dnekoz/WaterPressureSensor/hardware/visualization/assembly-top.png

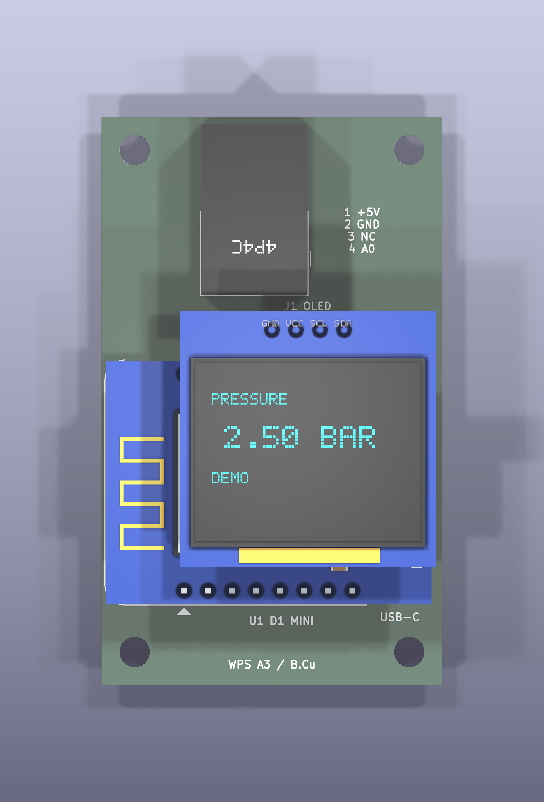
hardware/visualization/assembly-top.png
