dnekoz/WaterPressureSensor/hardware/review/carrier-bare-isometric.png

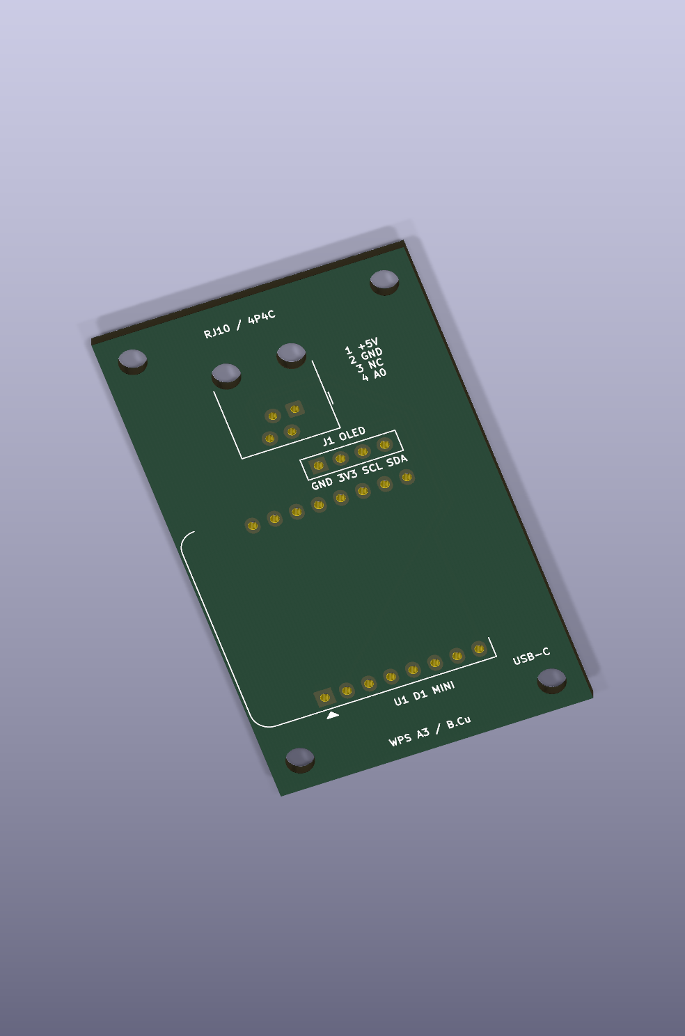
hardware/review/carrier-bare-isometric.png
