dnekoz/WaterPressureSensor/hardware/README.md

# WaterPressureSensor — аппаратная часть

Состояние: **A3, плата разведена и проверена в KiCad; выпуск для изготовления
ожидает сверки механики с реальными модулями**.

Для варианта изготовления на ЧПУ 3018 пользователь 18.10.2026 уточнил материал:
**текстолит 2 мм, медь 70 мкм**. Этот вариант, фотошаблоны, черновые УП и проверки
описаны в [cnc/README.md](cnc/README.md); старые допущения о толщине ниже к нему
не применять. Основная геометрия PCB сохранена; CAM-копия находится в `cnc/inputs/`.

Плата **36 × 60 мм**, исходная CAD-толщина 1,6 мм, одна физическая сторона меди **B.Cu**.
Все шесть цепей разведены дорожками 0,4 мм, зазор 0,25 мм; переходных отверстий
и проволочных перемычек нет. Предварительно принята медь 35 мкм.

## Зафиксированные требования

- KiCad 10.0.6; плата-носитель готовых модулей WeMos D1 Mini **USB Type-C** и SSD1306.
- Питание только через USB-разъём WeMos. Отдельный вход питания отсутствует.
- Датчик подключается через **RJ-10, 4P4C, гнездо для монтажа на плату**.
  Кабель датчика уже собран; пользователь задал контакты 1, 2 и 4.
- Сигнал датчика подключается непосредственно к A0. Внешнего делителя,
  фильтра и иных элементов согласования в этой версии нет.
- Одна сторона меди: B.Cu. Компоненты и разъёмы — с верхней стороны.
- OLED находится **вторым ярусом поверх WeMos**, подключается к высокому
  разъёму 1×4 «мама», установленному рядом с WeMos. Это последнее явное
  уточнение пользователя; вариант с двумя модулями рядом отменён.
- Нужно сохранить доступ к USB и кнопке Reset, проверить зазор по высоте,
  область антенны и возможность разборки.

## Соединения, подтверждённые прошивкой

| Сеть | Вывод WeMos | GPIO | Номер в символе U1 | Назначение |
|---|---|---|---|---|
| SENSOR_SIG | A0 | ADC | 2 | Сигнал датчика, без внешнего согласования |
| I2C_SDA | D2 | 4 | 13 | OLED SDA |
| I2C_SCL | D1 | 5 | 14 | OLED SCL |
| +3V3 | 3V3 | — | 8 | Выход встроенного стабилизатора |
| +5V_USB | 5V | — | 9 | Питание от USB WeMos |
| GND | GND | — | 10 | Общая земля |

Источники: `src/Config.h`, `src/Display.cpp`, файл варианта `d1_mini/pins_arduino.h`
из установленного ESP8266 Arduino Core 3.1.2. Назначения совпадают с README
прошивки. OLED RESET не подключается; `OLED_RESET = -1`.

Номера контактов U1 относятся к локальной копии стандартного символа
KiCad `RF_Module:WEMOS_D1_mini`. Это не нумерация GPIO.

## Распиновка датчика RJ-10, заданная пользователем

| Контакт J2 | Сеть | Соединение |
|---|---|---|
| 1 | +5V_USB | Вывод 5V WeMos, питание от его USB |
| 2 | GND | Общая земля |
| 3 | Резерв | Не подключается на плате-носителе, отмечен NC |
| 4 | SENSOR_SIG | Непосредственно A0 WeMos |

Эти соединения внесены в редактируемую схему и проверяются по экспортированному
netlist. При назначении посадочного места нумерацию его выводов необходимо
сверить с чертежом конкретного гнезда, включая вид со стороны пайки.
Контакт 3 принят как неиспользуемый на плате: пользователь назначил только
контакты 1, 2 и 4. Это допущение записано отдельно в `design.json`.

## Подключение OLED

Порядок контактов **при виде на лицевую сторону дисплея, слева направо**
задан пользователем. В схеме используются физические номера 1–4:

| Контакт J1 | Назначение OLED | Соединение с WeMos |
|---|---|---|
| 1, крайний слева | GND | GND |
| 2 | VCC | 3V3 |
| 3 | SCL | D1 / GPIO5 |
| 4, крайний справа | SDA | D2 / GPIO4 |

В [предоставленной карточке модуля](https://www.datasheethub.com/ssd1306-128x64-mono-0-96-inch-i2c-oled-display/)
указаны питание 3–5 В и габариты модуля 27 × 27 × 3,5 мм. Для проекта выбрано
питание OLED **3,3 В от WeMos**: таким образом подтяжки линий I²C к питанию
OLED находятся в домене 3,3 В ESP8266. Внешний источник питания не добавлен.

Карточка описывает типовой модуль, без конкретного артикула производителя.
Приложенный PDF — документация микросхемы SSD1306, а не размерный чертёж
четырёхконтактной платы дисплея. Поэтому 27 × 27 × 3,5 мм пока служат габаритной
оценкой: шаг контактов, смещение ряда относительно края, отверстия и высоту
сочленённого высокого разъёма ещё необходимо проверить. Номера 1–4 при
монтаже нельзя зеркально переносить с вида со стороны пайки.

## Конструкция платы A3

Переразводка основана на сохранённых пользователем правках PCB от 17.10.2026
19:10. Сохранён порядок сверху вниз: RJ-10, высокий разъём OLED, WeMos;
USB направлен вправо. Плата уменьшена с 46 × 65 до **36 × 60 мм**,
площадь сократилась на **27,8%**. Положение RJ-10 сохранено, WeMos сдвинут
вверх на 5 мм, OLED — вправо на 5,5 мм и вверх на 3 мм. Это сокращает промежутки
и оставляет 0,99 мм между габаритом OLED и областью антенны в плане.
Перенесены правые и нижние отверстия M3 под новый контур.
Площадки, электрические сети, ориентации, UUID и библиотечные связи модулей
взяты из пользовательского файла. Его исходная копия сохранена в
`WaterPressureSensor-backups/before-compact-routing-20261017-191204/`.

- WeMos повёрнут USB-разъёмом вправо. Принята стандартная посадка D1 Mini:
  два ряда по восемь контактов, шаг 2,54 мм, расстояние между рядами 22,86 мм.
  Type-C подтверждён пользователем; это ещё не подтверждает точную ревизию
  модуля или механическую идентичность конкретного клона.
- OLED находится над WeMos со смещением вправо от области антенны. Высокий
  разъём J1 расположен выше корпуса WeMos в плане, крайний левый контакт — GND.
  На Dwgs.User показан габарит OLED 27 × 27 мм. Приняты шаг контактов 2,54 мм
  и расстояние от ряда до края OLED 2 мм; эти два размера пока являются допущениями.
- Для J1 выбран **Samtec ESW-104-44-G-S**, корпус высотой **18,67 мм**.
  Высота корпуса не равна окончательному зазору между платами: проверьте
  фактическое сочленение с гребёнкой OLED, высоту WeMos на двух гнёздах 1×8
  и компоненты на нижней стороне OLED. Обычное гнездо с длинными выводами
  не обязательно обеспечивает такую же высоту над платой.
- J2 использует стандартный символ KiCad `Connector:4P4C` с четырьмя
  контактами 1–4. Контакты 1, 2 и 4 соединены согласно таблице выше.
  Для корпуса выбран футпринт семейства **EVERCOM 5301-4P4C / 5301-440xxx**.
  Его исходное имя в библиотеке KiCad — `RJ9_Evercom_5301-440xxx_Horizontal`:
  это четырёхконтактный корпус, используемый под обозначениями RJ9/RJ10.
  Контакт 3 оставлен резервным, без соединения. Другие RJ-10 не гарантируют
  совпадение отверстий и фиксаторов с этим семейством.
- Добавлены четыре отверстия 3,2 мм под крепёж M3. Отверстия крепления самого
  OLED не сверлятся: их размерный чертёж пока отсутствует. При необходимости
  механическую опору свободного края OLED следует согласовать с корпусом.
- Область запрета меди антенны из исходного футпринта WeMos сохранена.
  Разводка через неё не проходит. Характеристики Wi-Fi требуют проверки
  на собранном прототипе с установленным дисплеем и корпусом.
- Флаги питания обозначают существующий источник внутри WeMos/USB;
  это не дополнительные детали на плате.

## Проверки механики перед изготовлением

1. Наложить реальный Type-C WeMos на `review/fit-check-1to1.pdf`, проверить
   оба ряда контактов, ориентацию, доступ к USB и Reset. Печать — 100%,
   без масштабирования; расстояние между контрольными рисками должно быть 10 мм.
2. Размерный чертёж посадки OLED: шаг контактов, положение их центров
   относительно края, крепления и высота высокого разъёма. Порядок выводов
   и питание уже внесены; габаритная оценка модуля — 27 × 27 × 3,5 мм.
3. Сверить артикул и чертёж реального RJ-10 с выбранным семейством EVERCOM:
   четыре контакта, два пластиковых фиксатора и нумерацию со стороны пайки.
   Распиновка контактов 1, 2 и 4 уже подтверждена пользователем;
   контакт 3 не используется на плате.
4. Модель датчика, его питание, ток и диапазон сигнала. Для прямого входа
   следует проверить совместимость с A0 конкретного WeMos; текущая калибровка
   прошивки 0,5–4,5 В сама по себе её не подтверждает.
5. Ограничения корпуса/креплений и способ изготовления однослойной платы.

Посадочные места, контур и трассировка уже созданы. Gerber и сверловка
экспортированы как **A3-review**, не как проверенный выпуск в производство.
Точные размеры реальных модулей, 3D-зазоры и паспорт датчика программными
проверками не подтверждены.

KiCad использует минимальный двухслойный стек и нормализует сквозные площадки
как `*.Cu`. Это особенность CAD-исходника: **в пакет выведен только B.Cu**,
файл F.Cu отсутствует. Для изготовления нужна одна сторона меди. Все паяные
соединения доступны снизу, металлизация отверстий для электрической связности
не нужна. В Excellon объединены 30 отверстий: 24 контактных и 6 механических;
отчёт сохраняет их исходные категории PTH/NPTH из KiCad.

## Файлы и воспроизведение

- `WaterPressureSensor.kicad_pro` — проект KiCad.
- `WaterPressureSensor.kicad_sch` — редактируемая логическая схема.
- `WaterPressureSensor.kicad_pcb` — разведённая плата.
- `WaterPressureSensor.kicad_sym`, `sym-lib-table` — локальные символы.
- `WaterPressureSensor.pretty/`, `fp-lib-table` — локальные посадочные места.
- `design.json` — требования, сети и незаполненные аппаратные параметры.
- `tools/build_schematic.py` — воспроизводимое построение логической схемы.
- `tools/check_netlist.py` — сверка экспортированного netlist с таблицей сетей.
- `tools/build_board.py` — исходный генератор компоновки A2 и общий маршрутизатор B.Cu;
  не запускать его `main` для восстановления A3.
- `tools/compact_board.py` — уменьшение и переразводка на основе сохранённой
  пользовательской компоновки; текущий источник PCB не создаётся заново.
- `tools/check_board.py` — проверка платы, связности, слоя и экспортного пакета.
- `tools/export_review.ps1` — ERC/DRC, экспорт и упаковка.
- `exports/WaterPressureSensor-A3-review.zip` — Gerber, сверловка, BOM,
  STEP носителя, исходники KiCad и материалы проверки. Не выпуск в производство.
- `review/` — экспорт схемы, netlist и отчёт ERC; это материалы проверки,
  шаблон 1:1 и изображения платы.

Первичная генерация требует установленной библиотеки KiCad; для открытия
готовой схемы используются локальные и встроенные в схему символы.

```powershell
& 'C:\Program Files\KiCad\10.0\bin\python.exe' hardware/tools/build_schematic.py
& 'C:\Program Files\KiCad\10.0\bin\kicad-cli.exe' sch erc --exit-code-violations --format json --output hardware/review/erc.json hardware/WaterPressureSensor.kicad_sch
```

Генератор не перезаписывает существующую схему без явного `--overwrite`.
Не запускайте перегенерацию поверх несохранённых правок редактора.

## Проверка A3

KiCad открыл схему и экспортировал PDF и XML netlist. Соединения U1, RJ-10
и всех четырёх физических контактов OLED сверены по netlist; PDF отрендерен
и просмотрен. Сверка схемы включает 25 проверок подключения и назначения GPIO.

**ERC пройден: 0 ошибок, 0 предупреждений**, проверка запущена с
`--exit-code-violations`; исключения нарушений не добавлялись. Контакт 3
RJ-10 и неиспользуемые контакты WeMos отмечены NC по назначению схемы.
**DRC пройден: 0 нарушений, 0 разрывов, 0 расхождений со схемой.**
Проверка запущена с `--schematic-parity --exit-code-violations`.
Копии всех трёх электронных посадочных мест совпадают с локальной библиотекой.
Исключения нарушений не добавлялись.

Аудит платы и экспортов включает 40 проверок: 24 электрических контакта,
45 сегментов общей длиной около 191,1 мм, только B.Cu, отсутствие переходных
отверстий, порядок контактов OLED, чистые отчёты ERC/DRC и единственный
медный Gerber. Проверены содержимое архива и отчёт 30 сверлений.

Осмотрены растровые экспорты схемы, посадки, меди и 3D-вид носителя.
STEP и 3D-вид содержат **только плату-носитель**: точные модели Type-C WeMos,
OLED, высокого разъёма и RJ-10 не представлены. Это не полная проверка сборки.

После сборки прототипа нужны измерение питания OLED/датчика и входа A0,
калибровка по эталонному давлению, проверка Wi-Fi с установленным экраном,
доступа к USB и отсутствия касания плат/компонентов.

Для повторного экспорта уже отредактированных исходников:

```powershell
& .\hardware\tools\export_review.ps1
# Либо из папки hardware / KiCad в распакованном архиве:
& .\tools\export_review.ps1
```

Скрипт экспорта не перестраивает и не перетрассирует плату.
Авторитетный источник A3 — текущий `WaterPressureSensor.kicad_pcb`.
`build_board.py` содержит первоначальную компоновку A2; его генератор не следует
запускать поверх A3. `compact_board.py` принимает сохранённую пользовательскую
компоновку через `--source` и отдельный `--output`; перезапись выхода требует
`--overwrite`. Сохранённые ручные правки редактора следует учитывать отдельно.

## Справочные источники

- [WeMos D1 mini: характеристики и чертежи](https://www.wemos.cc/en/latest/d1/d1_mini.html).
- [Схема D1 mini V4](https://www.wemos.cc/en/latest/_static/files/sch_d1_mini_v4.0.0.pdf).
- [Размерный чертёж D1 mini V4](https://www.wemos.cc/en/latest/_static/files/dim_d1_mini_v4.0.0.pdf).
- [Карточка OLED, предоставленная пользователем](https://www.datasheethub.com/ssd1306-128x64-mono-0-96-inch-i2c-oled-display/).
- [SSD1306: документация микросхемы](https://www.datasheethub.com/uploads/2022/08/ssd1306.pdf).
- Библиотека KiCad 10.0.6: `RF_Module:WEMOS_D1_mini` (символ).
- [Samtec ESW/ESQ: каталог с размерами корпуса](https://suddendocs.samtec.com/catalog_english/esw_th.pdf).
- Библиотека KiCad 10.0.6: `RF_Module:WEMOS_D1_mini_light` и
  `Connector_RJ:RJ9_Evercom_5301-440xxx_Horizontal` (исходные футпринты).

Ревизия V4 приведена как справочная, а не как подтверждение версии модуля
пользователя. Питание и механика реальных модулей ещё не проверены.

## Визуализация установленной сборки

В `visualization/` сохранена отдельная копия PCB с приближёнными локальными
3D-моделями WeMos USB-C, OLED на высоком разъёме и RJ-10. Рендеры
`assembly-isometric.png`, `assembly-side.png`, `assembly-top.png` показывают
сборку в трёх ракурсах. Открыть `visualization/WaterPressureSensor-assembled.kicad_pcb`
в редакторе платы и нажать Alt+3 для вращения. Папка `models` должна находиться рядом.
Пакет просмотра: `exports/WaterPressureSensor-A3-assembly-visualization.zip`.

Рабочий PCB, его дорожки и компоновка при создании визуализации не изменялись.
Высоты сочленения и форма корпусов приблизительные; это не проверка механической
совместимости с реальными деталями. Подробные допущения — в `visualization/README.md`.
Значение на OLED демонстрационное. Генератор — `tools/build_assembly_visual.py`.
