dnekoz/WaterPressureSensor/hardware/exports/A2-review/README.txt

A2 REVIEW EXPORT -- NOT RELEASED FOR FABRICATION

Carrier: 46 x 65 mm, 1.6 mm substrate, assumed 35 um copper.
ONE physical copper side: B.Cu (bottom). No F.Cu Gerber is supplied.
Tracks 0.4 mm; clearance 0.25 mm; no vias or wire jumpers.
KiCad uses a two-layer minimum stack and *.Cu through-hole pad definitions.
Only the B.Cu file is to be fabricated as copper. All solder joints are accessible
from the bottom; drill metallization is not needed for connectivity.
The Excellon file combines all 30 holes. Drill report identifies diameters.

Check the actual Type-C WeMos header geometry, the OLED 2.54 mm pin pitch/edge
offset and mated height, and the exact RJ10 jack footprint before ordering.
The included fit-check-1to1.pdf must be printed at 100%; verify the 10 mm ticks.
STEP contains the bare carrier only. It does not validate the module assembly.
BOM records the modules supplied by the user and unresolved exact supplier parts.
