dnekoz/WaterPressureSensor/hardware/cnc/holes-bottom.csv

ref | pin | nominal_diameter_mm | x_bottom_mm | y_bottom_mm
J2 |  | 3.2 | 16.09 | 51.35
J2 |  | 3.25 | 23.59 | 51.35
J2 | 1 | 0.9 | 18.0 | 45.0
J2 | 2 | 0.9 | 19.27 | 42.46
J2 | 3 | 0.9 | 20.54 | 45.0
J2 | 4 | 0.9 | 21.810000000000002 | 42.46
U1 | 1 | 1.0 | 27.28 | 10.0
U1 | 2 | 1.0 | 24.740000000000002 | 10.0
U1 | 3 | 1.0 | 22.2 | 10.0
U1 | 4 | 1.0 | 19.66 | 10.0
U1 | 5 | 1.0 | 17.12 | 10.0
U1 | 6 | 1.0 | 14.579999999999998 | 10.0
U1 | 7 | 1.0 | 12.04 | 10.0
U1 | 8 | 1.0 | 9.5 | 10.0
U1 | 9 | 1.0 | 9.5 | 32.86
U1 | 10 | 1.0 | 12.04 | 32.86
U1 | 11 | 1.0 | 14.579999999999998 | 32.86
U1 | 12 | 1.0 | 17.12 | 32.86
U1 | 13 | 1.0 | 19.66 | 32.86
U1 | 14 | 1.0 | 22.2 | 32.86
U1 | 15 | 1.0 | 24.740000000000002 | 32.86
U1 | 16 | 1.0 | 27.28 | 32.86
H2 |  | 3.2 | 3.5 | 56.5
H4 |  | 3.2 | 3.5 | 3.5
H1 |  | 3.2 | 32.5 | 56.5
H3 |  | 3.2 | 32.5 | 3.5
J1 | 1 | 1.0 | 18.0 | 37.5
J1 | 2 | 1.0 | 15.46 | 37.5
J1 | 3 | 1.0 | 12.920000000000002 | 37.5
J1 | 4 | 1.0 | 10.379999999999999 | 37.5
