dnekoz/WaterPressureSensor/hardware/cnc/CAM-preview.png

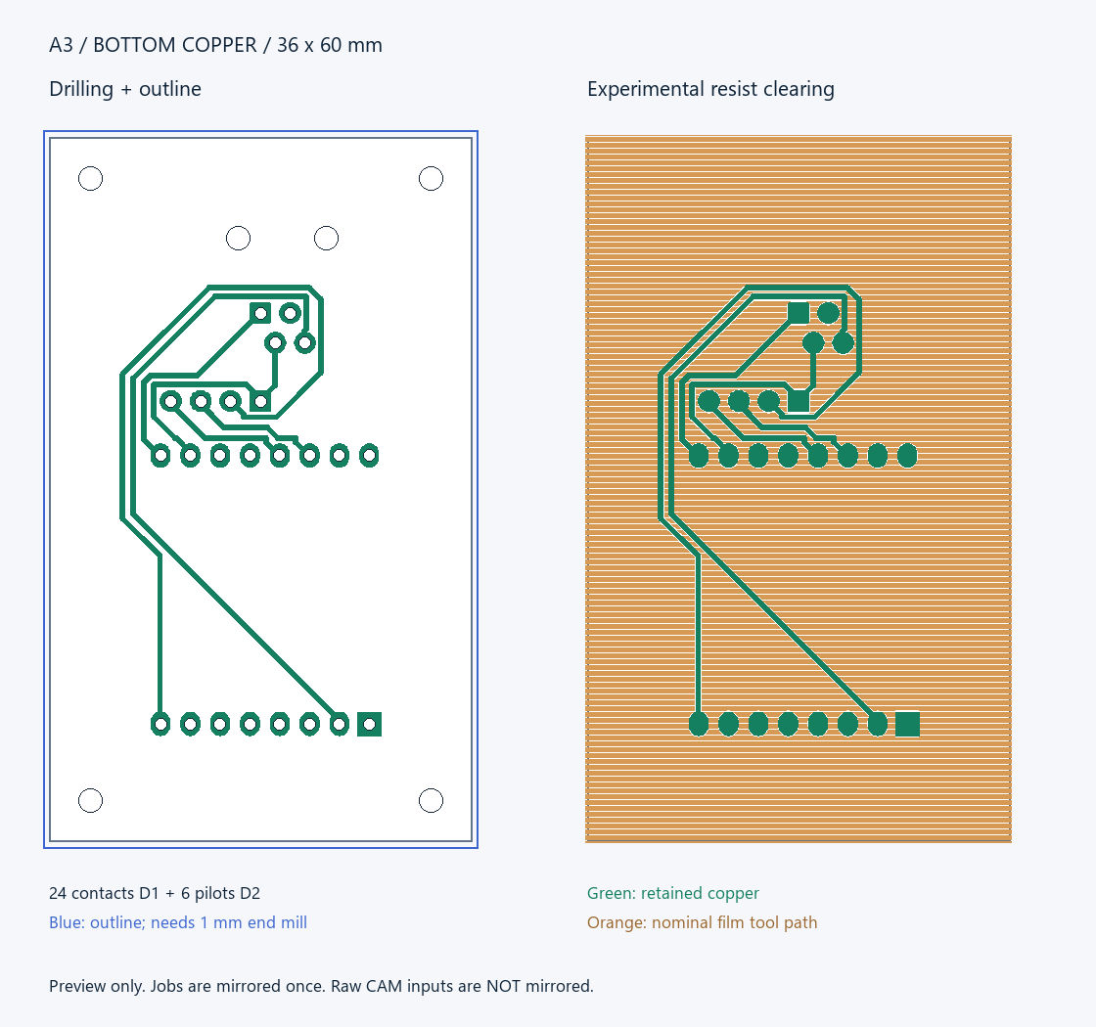
hardware/cnc/CAM-preview.png
