dnekoz/WaterPressureSensor/hardware/cnc/phototools/negative-preview.png

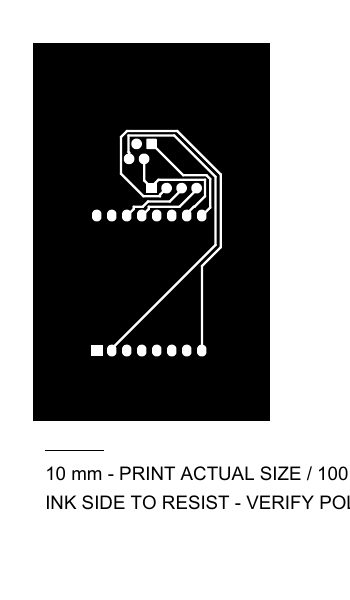
hardware/cnc/phototools/negative-preview.png
