dnekoz/WaterPressureSensor/hardware/review/board-layout.png

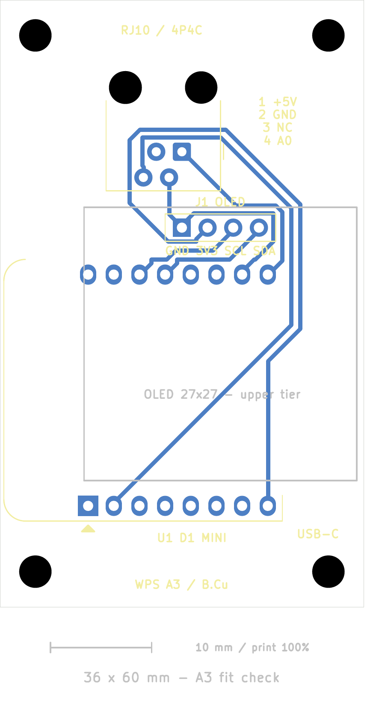
hardware/review/board-layout.png
