dnekoz/WaterPressureSensor/hardware/review/copper-bottom-full.png

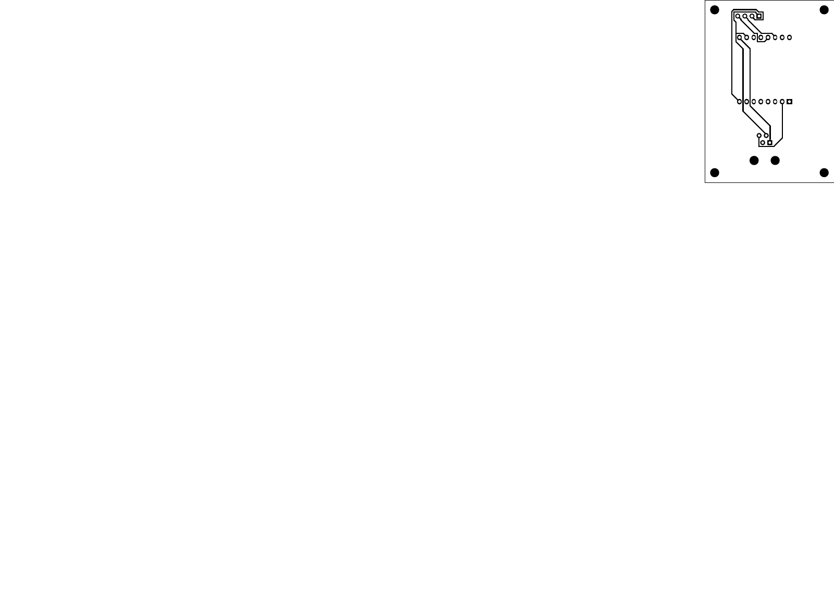
hardware/review/copper-bottom-full.png
