dnekoz/WaterPressureSensor/hardware/review/copper-bottom-view.png

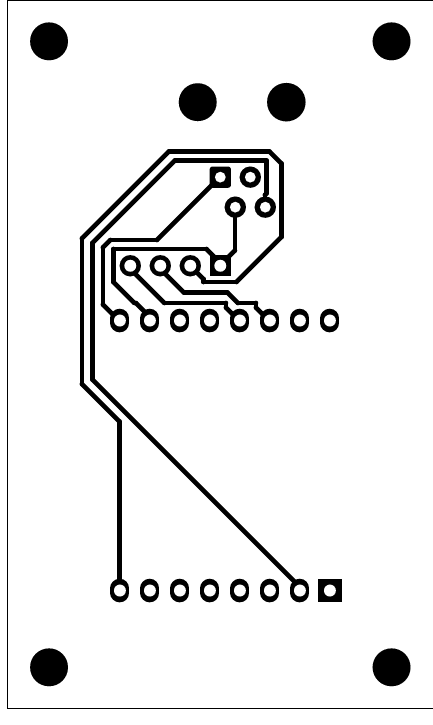
hardware/review/copper-bottom-view.png
