dnekoz/WaterPressureSensor/hardware/review/fit-check-1to1.png

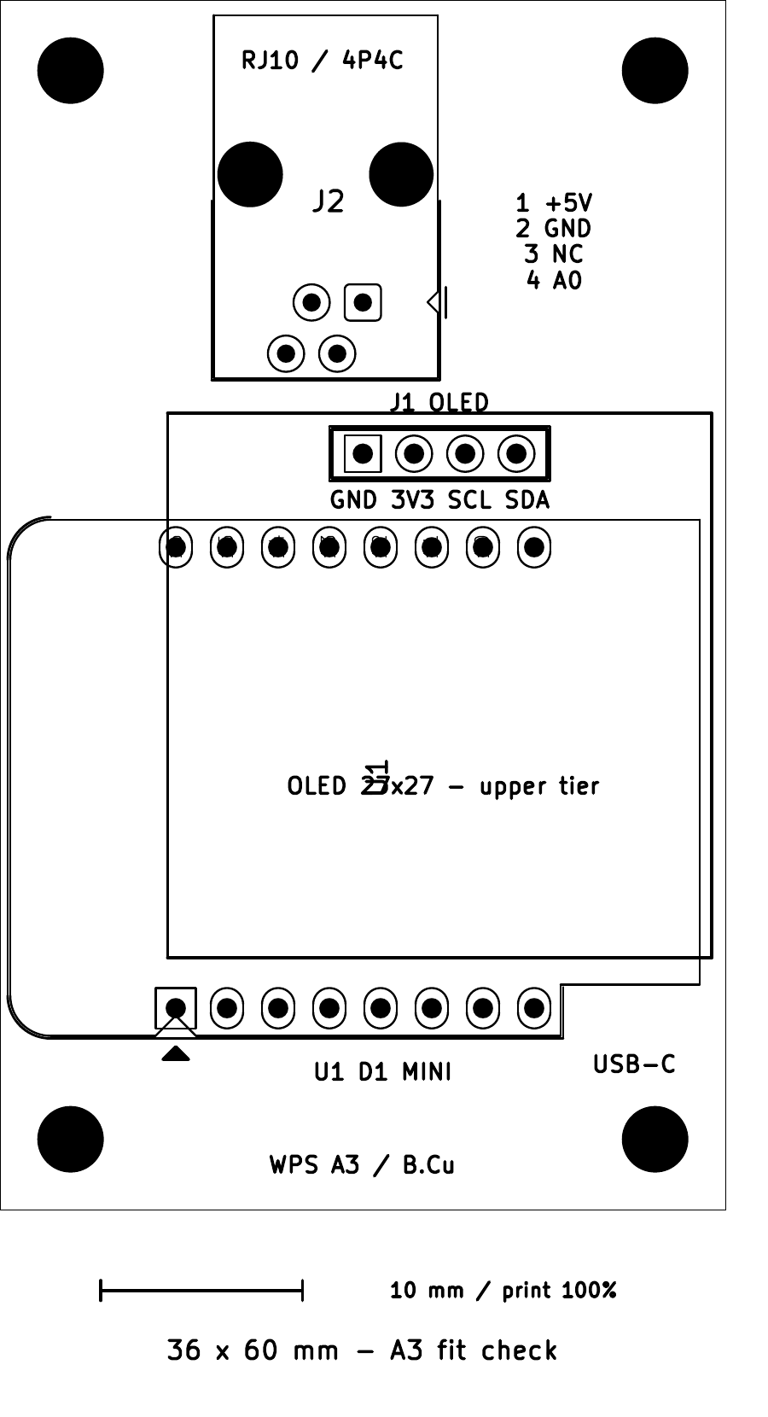
hardware/review/fit-check-1to1.png
