dnekoz/WaterPressureSensor/hardware/review/schematic.png

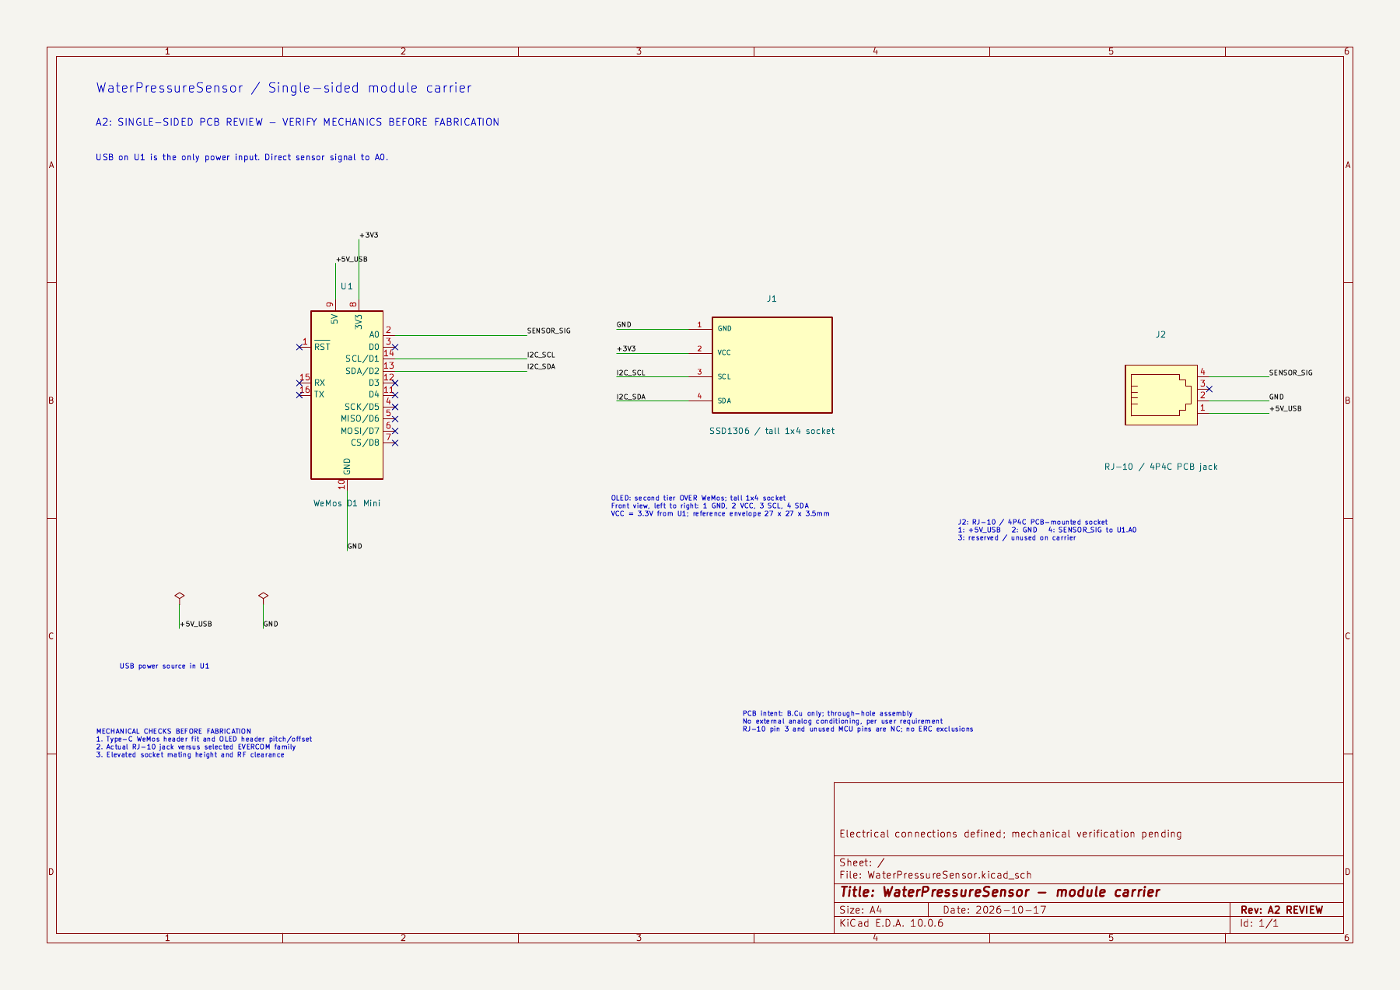
hardware/review/schematic.png
