dnekoz/WaterPressureSensor/hardware/review/wemos-dimension.png

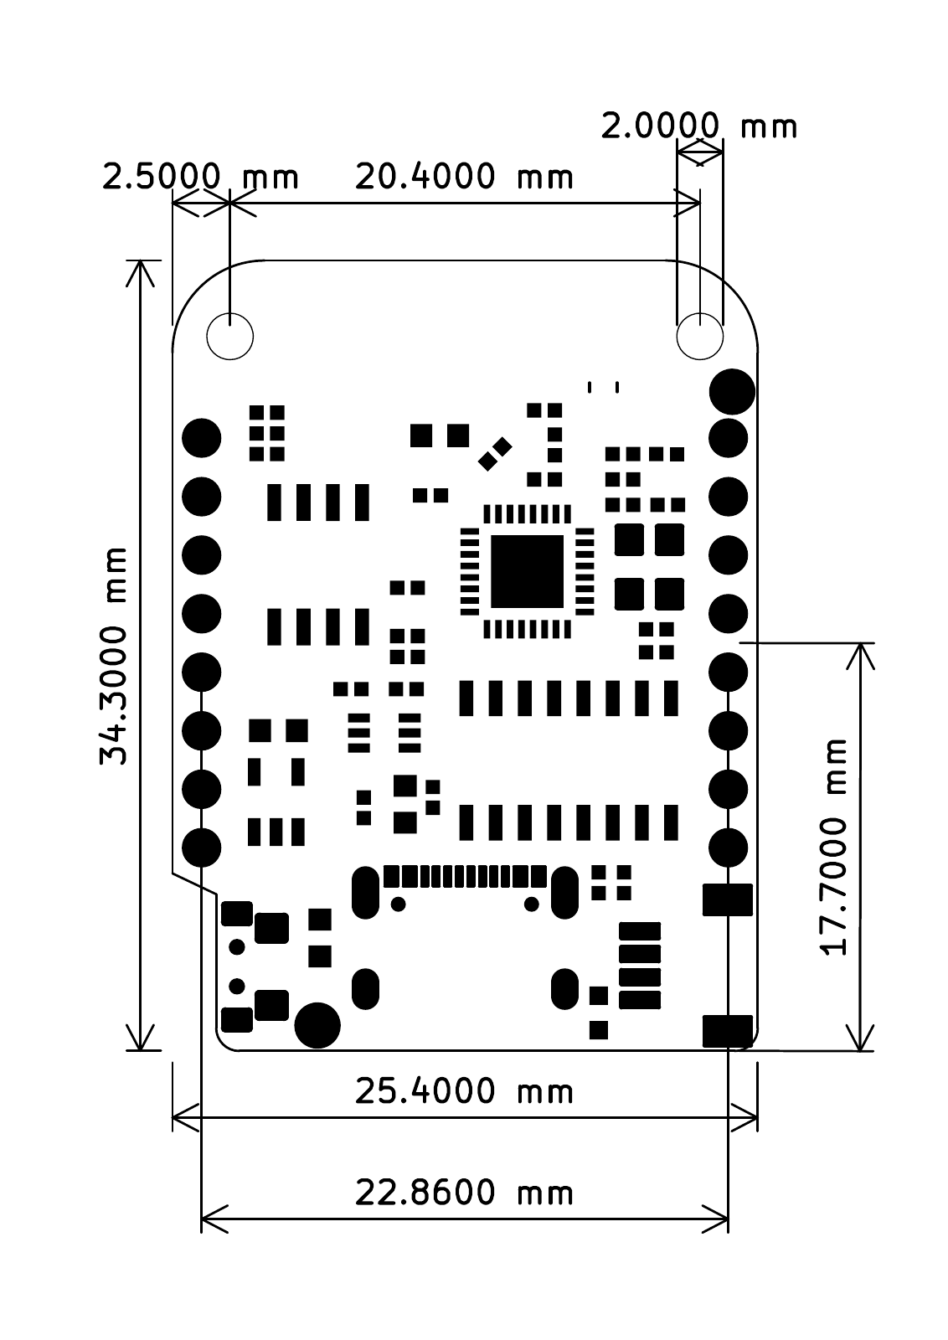
hardware/review/wemos-dimension.png
