dnekoz/WaterPressureSensor/hardware/exports/A2-review/WaterPressureSensor-carrier-only.step

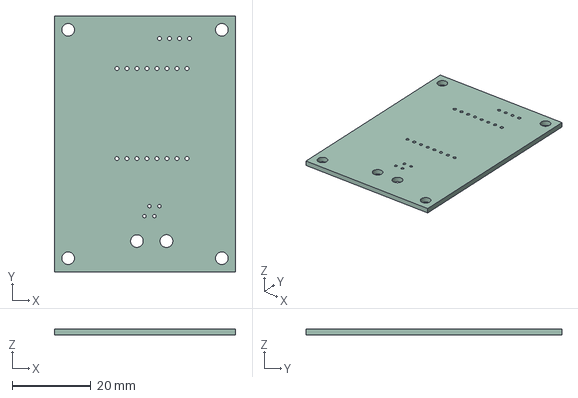
[picture p11: CAD file, 2026-10-24]
hardware/exports/A2-review/WaterPressureSensor-carrier-only.step
46.0 x 65.0 x 1.51 mm
