dnekoz/WaterPressureSensor/hardware/exports/A3-review/WaterPressureSensor-carrier-only.step

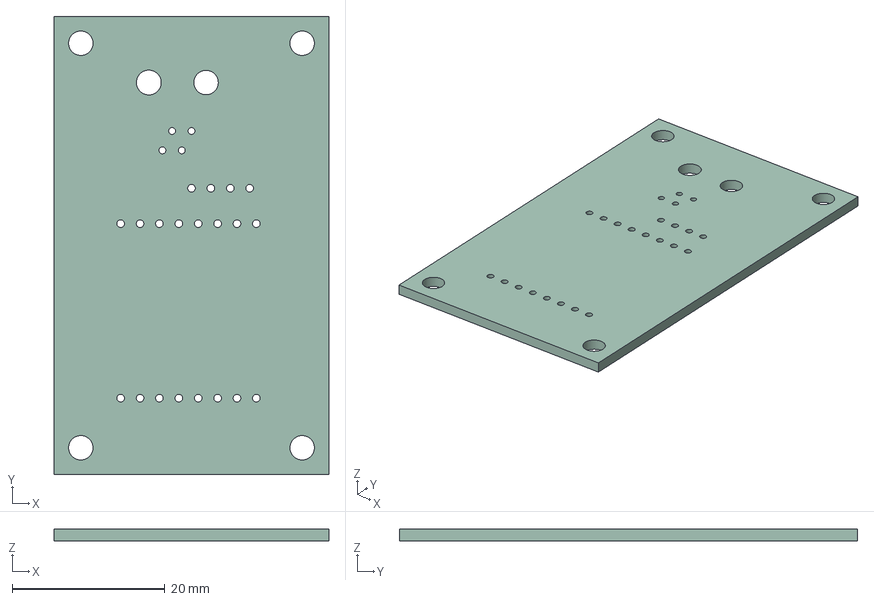
[picture p12: CAD file, 2026-10-24]
hardware/exports/A3-review/WaterPressureSensor-carrier-only.step
36.0 x 60.0 x 1.51 mm
