dnekoz/WaterPressureSensor/hardware/visualization/assembly-first.png

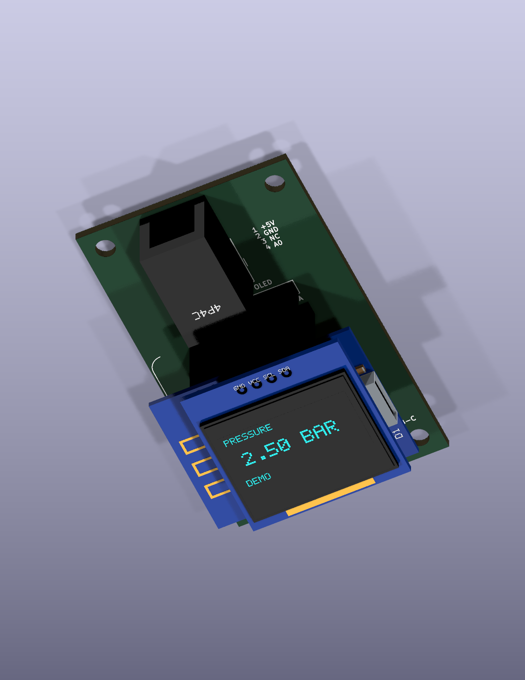
hardware/visualization/assembly-first.png
