dnekoz/WaterPressureSensor/hardware/visualization/assembly-low-angle.png

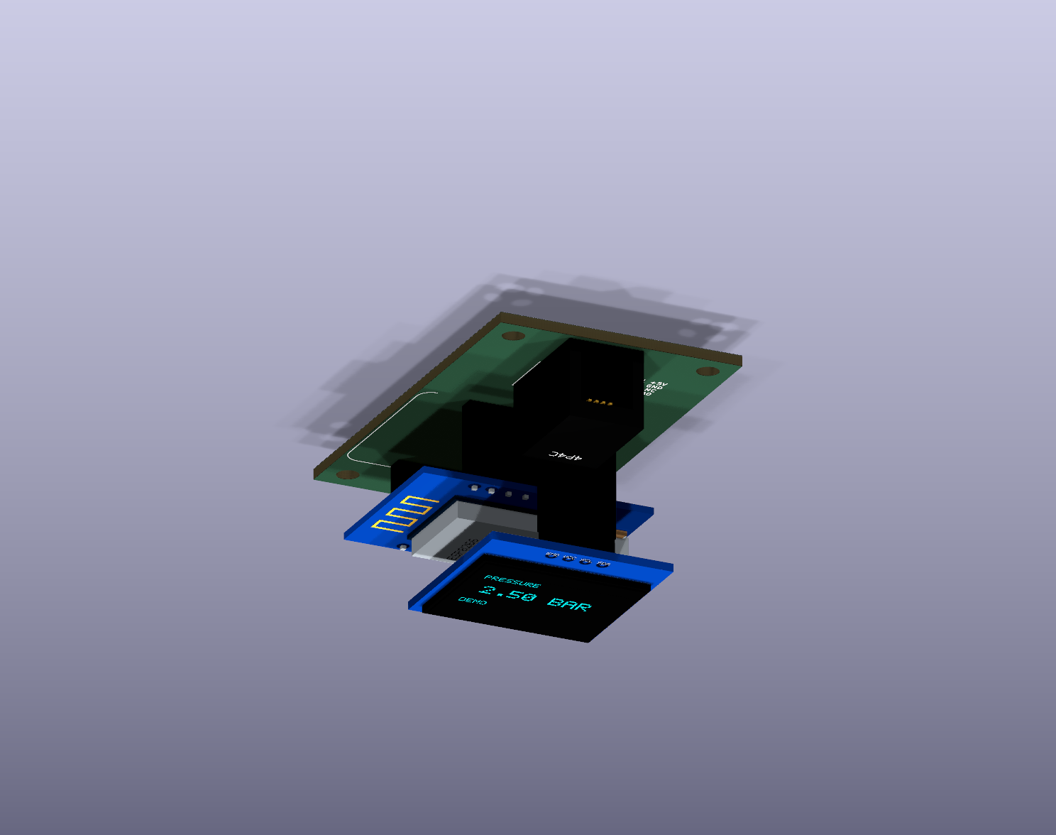
hardware/visualization/assembly-low-angle.png
