dnekoz/WaterPressureSensor/hardware/visualization/assembly-side.png

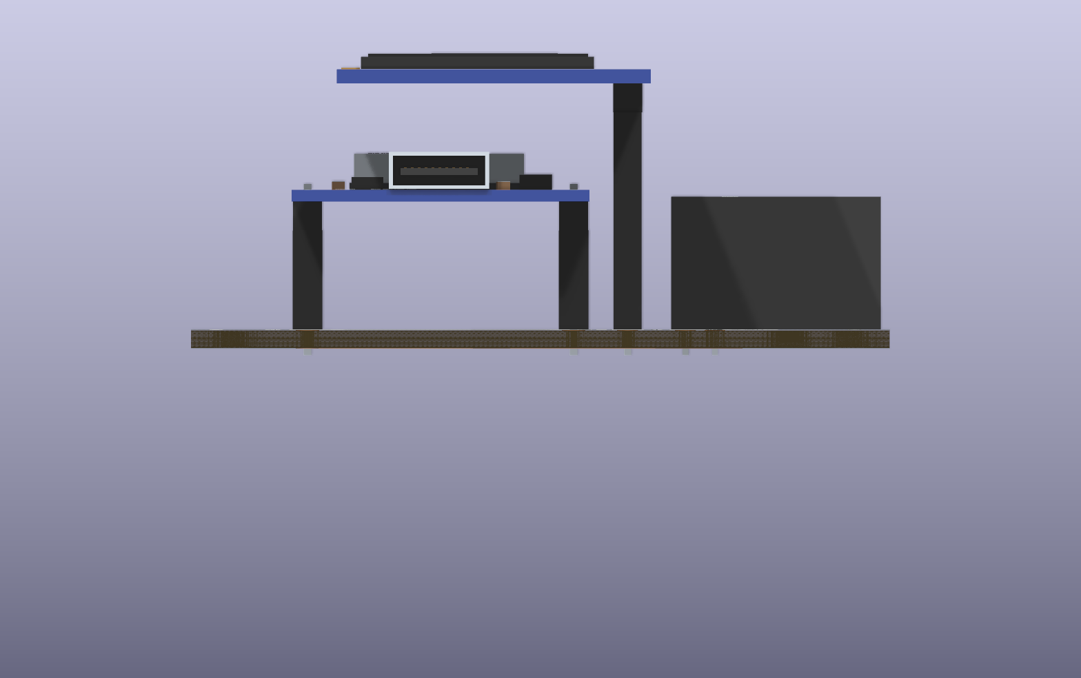
hardware/visualization/assembly-side.png
