dnekoz/WaterPressureSensor/docs/TEST_REPORT_3.1.md

# Проверка прошивки 3.1 — 25 октября 2026

Обычная прошивка **3.1** собрана и установлена через форму веб-обновления на
Wemos D1 mini `wps_24728b`, адрес **http://192.168.1.68/**.
Диагностическая прошивка не собиралась и не устанавливалась.

## Состав сборки

| Параметр | Значение |
|---|---|
| PlatformIO | `espressif8266@4.2.1` |
| Arduino Core | **3.1.2**, версия не менялась |
| NON-OS SDK | **3.0.5(b29dcd3)**, версия не менялась |
| Режим | Обычная release-сборка `d1_mini` |
| RAM по отчёту линковщика | **44 140 байт**, 53,9% |
| Flash по отчёту линковщика | **581 815 байт**, 55,7% |
| Размер BIN | **585 968 байт** |
| Файл | `.pio/releases/WaterPressureSensor-3.1-sdk305.bin` |

SHA-256 итогового BIN:

```text
fbba896fadb35392b36c69fd42ea8228625c1ac777e660c2eb26c07ea1b4b910
```

Проверка `scripts/verify_nonos_sdk.py` подтвердила настоящий символ
`SDK_VERSION` в ELF, версию в BIN и происхождение всех 11 используемых
библиотек SDK по карте линковки. На плате `/api/status` вернул ту же строку
`3.0.5(b29dcd3)` и `sdk_release = 3.0.5`.

## Изменение восстановления Wi-Fi

Перед попыткой подключения текущие параметры SDK очищаются в RAM,
STA выключается и включается снова через **не менее 200 мс после завершения
выключения**. Затем явно передаются SSID и пароль из копии менеджера.
Подход основан на подготовке подключения в Tasmota; ожидание реализовано
без блокирующего `delay()`, с сохранением резервной AP и flash.

Для сохранения той же сети отдельно восстанавливается RAM перед вызовом
`begin()` с записью flash: Arduino Core может пропустить установку параметров,
если сохранённый профиль не изменился. Успех подключения требует
`WL_CONNECTED` и ненулевого IP. При длительном отсутствии связи подготовка
повторяется каждые 30 секунд.

## Автоматические проверки

Команды:

```sh
pio test -e native
pio run -e d1_mini -j 2
python scripts/verify_nonos_sdk.py
```

**154 из 154 тестов прошли** в восьми наборах, включая 16 проверок
производственного менеджера Wi-Fi с имитацией SDK:

- Граница 199/200 мс и отсчёт паузы после медленного выключения STA.
- Возврат роутера после длительного отсутствия, в том числе после закрытия AP.
- Самостоятельное восстановление SDK и новый отсчёт 30 секунд после очередного обрыва.
- Смена профиля во время ожидания, повторное сохранение того же профиля и сохранение новых параметров после ошибки SDK.
- Сохранность flash, открытая сеть, отсутствие конфигурации, ошибки отключения и смены режима.
- Статус подключения без IP, переполнение `millis()` и закрытие AP во время паузы STA.

Обычная сборка завершилась успешно. Предупреждения Python в поставляемом
`elf2bin.py` не помешали формированию BIN.

## Испытания итогового образа на плате

Повторная установка окончательного BIN и проверки выполнялись
**17:56–17:57 по Москве** через настоящий Google Chrome в headless-режиме.
Этот прогон относится к SHA-256 выше, включая исправление повторного
сохранения той же сети.

| Проверка | Результат |
|---|---|
| Вход и OTA через веб-форму | HTTP 200; после перезапуска версия **3.1** |
| Wi-Fi после OTA | Подключён, IP **192.168.1.68** |
| MQTT после OTA | Подключён, TLS включён |
| Датчик после OTA | Нет `fault`, `over` и устаревшего измерения |
| Настройки после OTA | Возвращаемые API значения совпали со снимком до обновления |
| Повторное применение текущей Wi-Fi сети | **3 успешных цикла**, без перезапуска платы |
| Резервная AP при этих циклах | API подтвердил AP активной после восстановления STA; между циклами AP закрылась |
| MQTT после повторных подключений | Восстановился во всех трёх циклах |
| Настройки после повторных подключений | Совпали с исходным снимком |
| Четыре раздела, светлая/тёмная темы | Проверены в Chrome при ширине **390 и 1440 px**; горизонтального переполнения нет |
| Ошибки JavaScript | Не обнаружены |
| Перезапуск через веб-интерфейс | Успешен, время работы сброшено; Wi-Fi и MQTT/TLS восстановились |
| Настройки после перезапуска | Совпали с исходным снимком |

Пароли API не возвращает: их сохранность проверена косвенно успешным повторным
подключением Wi-Fi, MQTT и входом в интерфейс после перезапуска.
TLS проверен с текущими настройками брокера; отдельная проверка сертификата
и всех режимов TLS в этот прогон не входила.

## Границы проверки

**Перезагрузка роутера и отсутствие сети на 1–2 минуты не проверялись:**
пользователь сообщил, что сейчас перезагрузить роутер нельзя.
Три переподключения через форму проверяют подготовку STA и применение
профиля, но не воспроизводят исходный отказ WPA после перезапуска роутера.
По этим результатам нельзя утверждать, что первоначальная проблема
окончательно устранена. Длительное наблюдение в течение двух суток
также не выполнялось.

Пауза 200 мс проверена native-тестом с управляемыми часами и кодом менеджера.
Её длительность на плате по USB Serial отдельно не измерялась: последовательный
порт во время испытаний не был доступен. Доступность резервной AP проверялась
по состоянию API, подключение к ней отдельного клиента не выполнялось.
Физическая точность датчика и калибровка этим прогоном не проверялись.

## Локальные материалы

- `.pio/native-tests-3.1.log` — полный результат 154 тестов.
- `.pio/build-3.1.log` — сборка окончательного образа.
- `.pio/hardware/test-3.1-final-console.log` — этапы OTA и испытаний.
- `.pio/hardware/3.1-final-tests/` — результат, ответы API, снимки настроек,
  три переподключения, статусы после OTA и перезапуска, скриншоты Chrome.
- `.pio/hardware/3.1-tests/router-test-result.json` — отметка о непроведённом
  испытании с перезагрузкой роутера.

Материалы `.pio/` локальные и исключены из Git; пароли и cookie в отчёт
не включены.
