dnekoz/WaterPressureSensor/docs/TEST_REPORT_3.0.1.md

# Проверка WaterPressureSensor 3.0.1

Дата: 9 сентября 2026 года. Плата на COM4: ESP8266EX, flash 4 МБ, идентификатор `wps_8ea5a0`. Сборка PlatformIO: `d1_mini`, ESP8266 Arduino Core 3.1.2.

## Сборка и автоматические проверки

| Проверка | Результат |
|---|---|
| `pio test -e native` | 138 из 138 тестов прошли |
| Сборка и USB-загрузка | Успешны, контрольная сумма записанной прошивки проверена esptool |
| Статическая RAM | 42 788 из 81 920 байт, 52,2% |
| Flash приложения | 570 639 из 1 044 464 байт, 54,6% |
| Chrome 152.0.7977.83, демонстрационный сервер | 40 сочетаний раздела, темы и ширины; формы, ошибки, восстановление связи |
| Тот же Chrome, страницы с ESP8266 | 40 сочетаний; вход, выход, пять кнопок просмотра пароля, отсутствие горизонтального переполнения и ошибок JavaScript |

Проверены ширины 360, 390, 768, 1280 и 1440 пикселей. Это эмуляция размеров в настольном Chrome, не испытание на физическом телефоне. Кнопки просмотра пароля имеют область нажатия 44 × 44 пикселя. При выходе очищаются и скрываются в том числе раскрытые поля. Сохранённые секреты не возвращаются API. Прямая HTTP-проверка подтвердила gzip-сжатие HTML.

## Проверка на плате

- Прошивка отвечает версией `3.0.1`, подключается к сохранённой сети Wi-Fi и настроенному пользователем MQTT-брокеру.
- Новый пароль интерфейса и AP `water1234` установлен на этой плате через API; вход проверен до и после перезапуска. Смена пароля аннулирует старую сессию. Остальные настройки, включая учётные данные Wi-Fi и MQTT, сохранены.
- Serial подтверждает успешный запуск `WaterSensor-8ea5a0` на `192.168.4.1`. При повторном подключении к сохранённой Wi-Fi сети появляются сообщения о потере и восстановлении Wi-Fi и MQTT.
- Несуществующее DNS-имя даёт `[MQTT][DNS]` с советом проверить имя и DNS либо использовать IP.
- Недоступный TCP-порт даёт код `-2`, причину, подсказку и время следующей попытки. HTTP-интерфейс остаётся доступен между попытками.
- Неверный пользователь на настроенном брокере вызвал код `5`. Подсказка предлагает проверить логин, пароль и права. Повторы остановлены; после сохранения правильных настроек соединение восстановлено.
- Порт `0` отвергается с HTTP 400 и `[CONFIG][ERROR]`, действующие настройки не меняются.
- Выбор проверки TLS по CA без загруженного сертификата даёт `[TLS][CA]` с указанием раздела и формата PEM.
- После завершения испытаний исходные настройки MQTT восстановлены и подключение подтверждено. Ошибки хранилища отсутствуют.

Локальный тестовый MQTT-сервер не был доступен плате из-за входящих сетевых ограничений компьютера. Добавить временное правило Windows Firewall не удалось: ОС вернула отказ в доступе; настройки брандмауэра не изменены. Поэтому отдельные ответы CONNACK `3`, `4` и отсутствие CONNACK (`-4`) на реальном соединении не воспроизводились. Их классификация проверена native-тестами. Успешное соединение и отказ в доступе проверены на уже настроенном брокере; реальные пароли не передавались сторонним брокерам.

## Границы аппаратной проверки

Во время испытания АЦП показывал около 2–3 отсчётов, пересчитанное напряжение — около 0,009 В. Прошивка сообщала `fault=true` и `bar=null`. OLED не обнаружен. Это подтверждает отображение ошибки сигнала, но не точность измерения давления. Нужны проверка подключения датчика и экрана, измерение напряжения и калибровка на физическом стенде.

Подключение отдельного клиента по радио к AP, полноценное TLS-рукопожатие с сертификатом пользовательского брокера и OTA в этом цикле испытаний не проверялись.

## Резервная копия

До замены на COM4 запускалась SenseAir S8 1.0.1. Сохранён полный образ flash размером 4 194 304 байта; MD5 всего образа сверена с платой. Копия вынесена из временной `.pio` в соседнюю с репозиторием папку `../device-backups/`:

- `com4-before-waterpressure-20260909.bin`
- `com4-before-waterpressure-20260909.sha256`

SHA-256: `e910d34a922353a0af41f15814ccfc8718beb0dbb2e6ee033db0c27af313af24`.

Образ содержит прежние настройки устройства и не добавлен в Git. Локальные журналы испытаний и снимки экрана находятся в `.pio/hardware/`, снимки демонстрационного интерфейса — в `.pio/ui-review/`.
