dnekoz/WaterPressureSensor/docs/WIFI_FAILURE_2026-10-24.md

# Сбой восстановления Wi-Fi 24 октября 2026 года

На ESP8266 `wps_24728b` с временной прошивкой `3.0.3-diag` воспроизведено устойчивое `W:--` после перезапуска роутера. По сообщению пользователя, роутер перезапускается по расписанию раз в двое суток, сеть отсутствует 1–2 минуты. Сохранённые события показывают, что последующее восстановление останавливается на четырёхстороннем обмене WPA. Внутренняя причина отказа обмена не установлена.

Местное время — Москва (UTC+3). Сборщик впервые не получил HTTP-ответ датчика в **22:09:23.328 МСК** (`19:09:23.328 UTC`); первый успешный ответ после выключения и включения платы получен в **22:18:03.341 МСК** (`19:18:03.341 UTC`). Интервал между этими наблюдениями — около 8 минут 40 секунд. Отдельная проверка HTTP-интерфейса роутера подтвердила его доступность уже в **22:10:17 МСК** (`19:10:17 UTC`). HTTP-доступность роутера сама по себе не доказывает исправность его службы WPA, но потеря связи с датчиком продолжалась существенно дольше первоначального перезапуска.

В неудачном запуске `e327ecb9` до обрыва были успешные `connected` и `got_ip`. В сохранённой части после обрыва:

- Зарегистрированы **24 отключения с `reason=15`** — `REASON_4WAY_HANDSHAKE_TIMEOUT` в установленном SDK. Повторные таймауты обычно разделены примерно 6,3 секунды; принудительные повторы подключения меняют этот интервал. Есть также 9 событий `reason=201` (`REASON_NO_AP_FOUND`), преимущественно перед серией таймаутов, и 4 события `reason=8`, следующие за принудительными повторами.
- Наблюдается `sdk=2` (`STATION_WRONG_PASSWORD`), `status=6`, `mode=1` (STA), `dhcp=1` (`DHCP_STARTED`) и IP `0.0.0.0`. После обрыва в сохранившихся событиях нет нового `connected` или `got_ip`. Статус SDK обозначает отказ установления защищённого соединения и не доказывает неверный сохранённый пароль.
- Все **7 зафиксированных вызовов `WiFi.reconnect()` вернули `true`**, каждый за **129–219 мс**. Следующие события снова показывают таймаут WPA. Возврат `true` подтверждает принятие запроса SDK, а не успешное подключение.
- Флаг DHCP означает, что клиент запущен; он не подтверждает начало DHCP-обмена после успешной аутентификации. В этом эпизоде отказ предшествует пригодному для работы Wi-Fi-соединению. Данных за зависание именно на DHCP нет.

После выключения и включения платы запуск `2e557fe2` подключился к тому же BSSID на канале **5** и получил IP через **1089 мс** после события `connected`. Это подтверждает возможность подключения с существующей конфигурацией после сброса. Смена канала, неверный сохранённый пароль или постоянная неисправность DHCP этим опытом не установлены.

Гипотеза о зависшем состоянии аутентификации или кэше ключей внутри ESP8266 остаётся гипотезой. Исходный журнал датчика не различал сообщения EAPOL; полученный позднее журнал Keenetic уточнил этап отказа — см. дополнение ниже. Ранее найденный условный дефект повторного подключения MQTT/TLS не объясняет зафиксированные таймауты WPA: при отсутствии Wi-Fi код MQTT не начинает подключение к брокеру. Во время сохранённых отказов свободная память держится около 19,4 КБ, крупнейший блок — 9256 байт; события SDK и повторы продолжаются. Это не доказывает отсутствие любого влияния ресурсов внутри закрытого SDK, но признаков нарастающей утечки или остановившегося основного цикла здесь нет.

Ограничение журнала: у `e327ecb9` отсутствуют записи **seq 9–75** из-за ротации. Исходное отключение с причиной **4** (`REASON_ASSOC_EXPIRE`) известно только по сохранённым полям `first_reason=4`, `first_reason_ms=335576`; исходная строка события не сохранилась. Метки uptime устройства и UTC сборщика не следует напрямую отождествлять. Часть архива содержит повреждённую строку NDJSON; выводы основаны на проверенных JSON-записях из объединённого файла и сохранённых снимков.

Отдельно около **22:21:13 МСК** (`19:21:13 UTC`) после запуска `2e557fe2` обнаружен новый запуск **`71d64437`, `reset=1`** — аппаратный watchdog. Его причина неизвестна. Это более позднее событие не объясняет предшествовавшее длительное `W:--`; причинная связь с диагностической прошивкой не доказана. После опыта на устройство возвращён сохранённый исходный файл прошивки **3.0.2**, настройки, Wi-Fi и MQTT проверены. Обычная сборка также проверена: RAM 42 908 байт, flash 571 827 байт, как до добавления диагностики. Диагностика остаётся отдельной временной сборкой. **Исправление восстановления в рамках этого исследования не реализовано.**

Архив относительно корня проекта: `.pio/hardware/wifi-diagnostics-20261024T190747.826410Z/`. Основные материалы: `merged-events.json` — проверенные объединённые события; `wifi-diagnostics.ndjson`, `diagnostics-latest.ndjson`, `diagnostics-final.ndjson` — журналы устройства; `status.ndjson` и `collector.ndjson` — ответы и ошибки с UTC сборщика. Каталог `.pio` исключён из Git; при передаче отчёта архив следует приложить отдельно.

## Дополнение: журнал Keenetic

Источник: предоставленный пользователем `C:/Users/Denis Nekoz/Downloads/log (1).txt`, 4000 строк. MAC датчика `40:f5:20:24:72:8b` сопоставлен с hostname `wps-24728b` и IP `192.168.1.69` в DHCP-записях. Приведённые ниже времена — МСК, после синхронизации часов роутера.

| Время | Наблюдение | Строки исходного журнала |
|---|---|---|
| 22:14:50–22:14:54 | AP 2,4 ГГц выбрал канал 5; другие клиенты успешно завершили WPA2 и получили IP | 3583–3584, 3596, 3603, 3614 |
| 22:14:57 | Роутер принял ассоциацию датчика | 3670 |
| 22:15:03–22:17:58 | 25 таймаутов `pairwise key handshaking timeout (msg 1 of 4-way)`, каждый сопровождается отключением датчика точкой доступа | 3734–3735 … 3917–3918 |
| 22:18:01 | После перезапуска датчика — успешное завершение WPA2 (`set key done`) | 3919–3920 |
| 22:18:01–22:18:03 | DHCP Discover → Offer → Request → ACK; выдан прежний IP | 3921–3924 |

До первого успеха роутер зарегистрировал 29 ассоциаций датчика, 25 таймаутов WPA и 4 отключения, инициированных станцией. Последние идут с периодом 30 секунд и согласуются с ручными повторами в прошивке. Впоследствии в 22:21:11–22:21:12 и 22:26:13 снова прошли успешные обмены ключами и DHCP (строки 3937–3943 и 3965–3970).

**Уточнённый установленный отказ:** роутер остаётся на этапе первого сообщения четырёхстороннего обмена WPA2. По протоколу M1 направлено от AP к станции, M2 — от станции к AP. Таймаут этого этапа означает, что AP не получил или не принял ожидаемый корректный M2. Это интерпретация журнала по [описанию последовательности WPA/WPA2](https://www.cisco.com/c/en/us/support/docs/wireless-mobility/wireless-lan-wlan/116493-technote-technology-00.html); сам журнал не является захватом радиообмена. Он не доказывает, что M1 дошло до ESP8266, что ESP8266 совсем не отправлял M2, либо что конкретный пакет был отброшен проверкой ключей.

Таким образом, ассоциация работает, а установка ключей WPA2 не завершается. Отказ DHCP, WAN-маршрутизации или MQTT не объясняет этот конкретный этап. Другие клиенты в тот же период проходили WPA2, а после сброса датчик подключился без дополнительной перезагрузки роутера. Отдельный дефект кэша ESP8266, неверный пароль, PMF, 802.11r или блокировка политикой журналами не доказаны.

В начале журнала часы меняются с 1 января на 24 октября (строка 77), затем снова синхронизируются NTP в 22:14:48 (3531–3532). Поэтому ранние отметки загрузки и применения конфигурации WPA2 нельзя использовать для точного измерения простоя. Строки `WPA PSK set` и отключение/включение WPA2 в 22:12:54 относятся к применению конфигурации WLAN; они не доказывают, что пользователь менял пароль. После NTP отметка DHCP ACK 22:18:03 согласуется с временем сборщика 19:18:03.341 UTC.
