dnekoz/WaterPressureSensor/hardware/review/board-layout.pdf

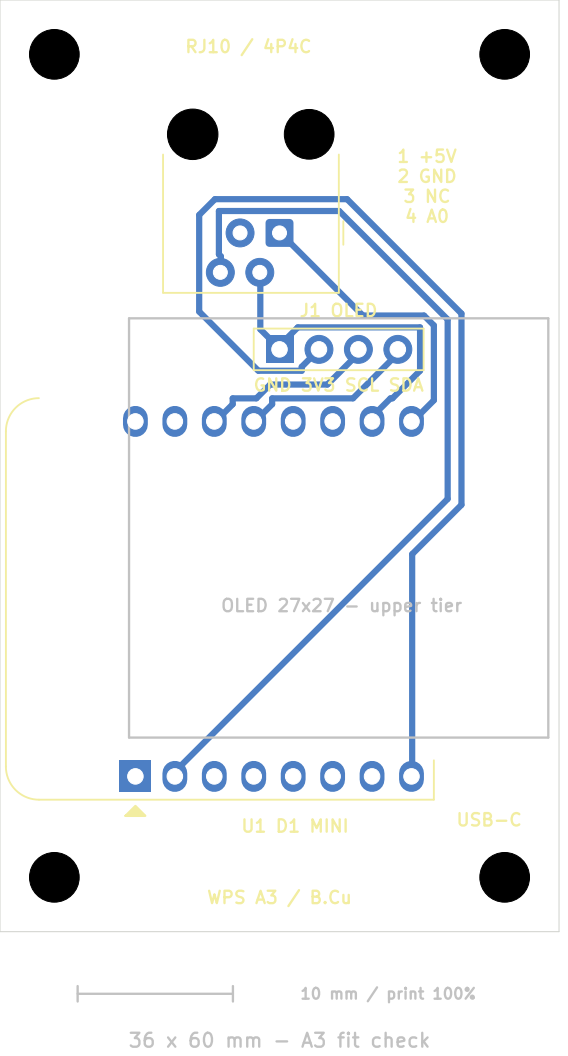
[picture p16: page 1]

RJ10 / 4P4C WPS A3 / B.Cu U1 D1 MINI J1 OLED
4 A0 USB-C

GND 3V3 SCL SDA 1 +5V 2 GND

10 mm / print 100% OLED 27x27 - upper tier 36 x 60 mm - A3 fit check
