dnekoz/WaterPressureSensor/hardware/review/schematic.pdf

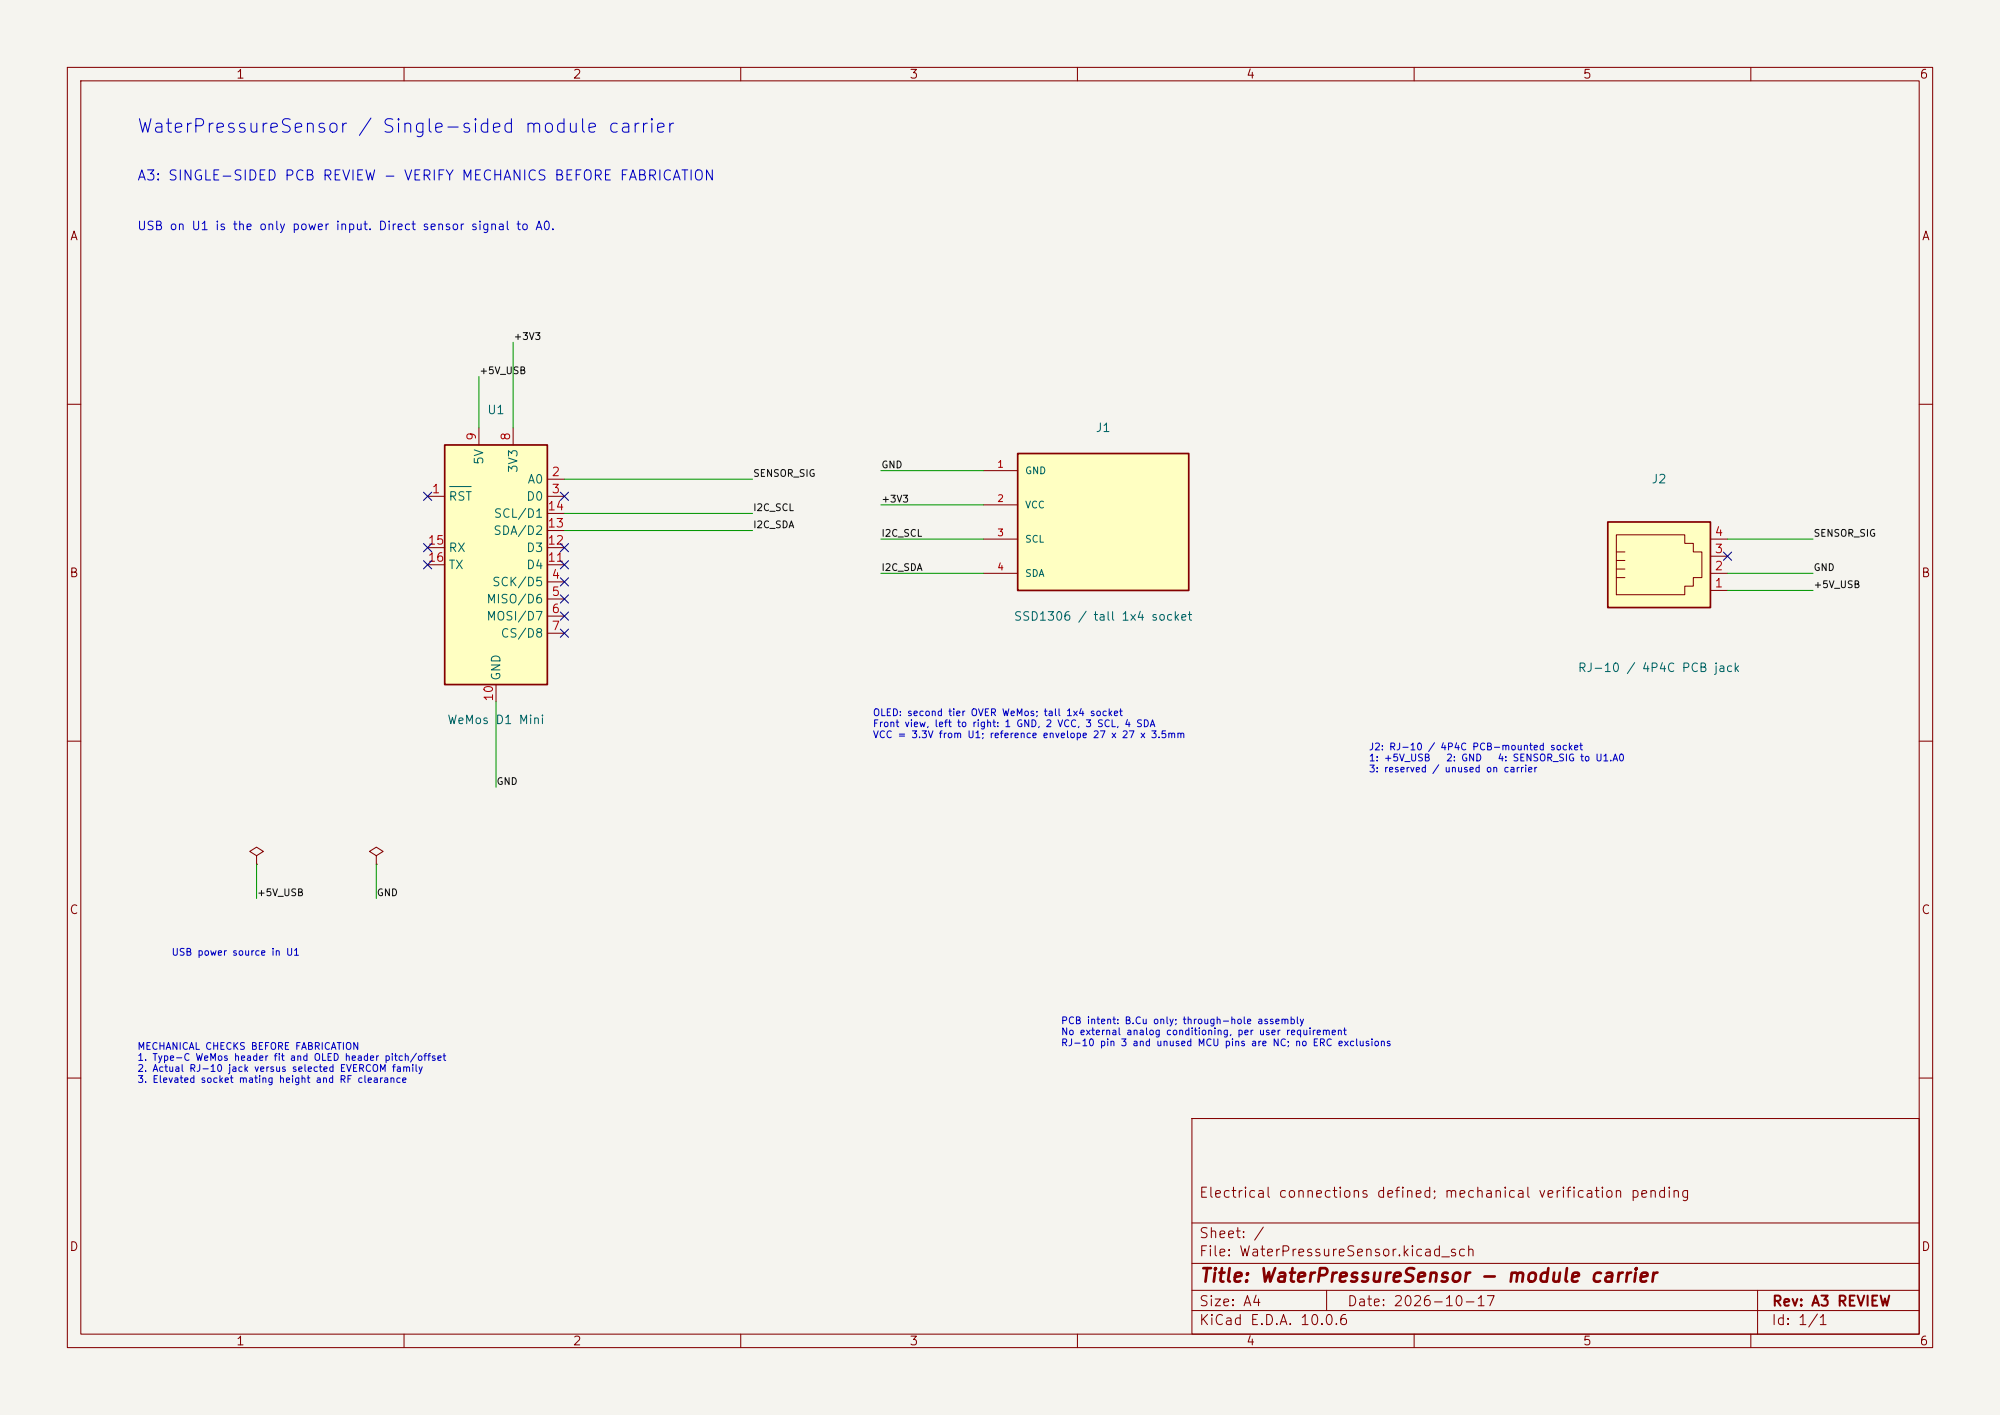
[picture p17: page 1]

GND USB on U1 is the only power input. Direct sensor signal to A0. WaterPressureSensor / Single-sided module carrier

A3: SINGLE-SIDED PCB REVIEW - VERIFY MECHANICS BEFORE FABRICATION

8 5V 9 GND 10 D4 11 D3 12 SDA/D2 13 SCL/D1 14 RX 15

3: reserved / unused on carrier OLED: second tier OVER WeMos; tall 1x4 socket Front view, left to right: 1 GND, 2 VCC, 3 SCL, 4 SDA

VCC = 3.3V from U1; reference envelope 27 x 27 x 3.5mm

USB power source in U1 MECHANICAL CHECKS BEFORE FABRICATION

Electrical connections defined; mechanical verification pending

Sheet: /
File: WaterPressureSensor.kicad_sch
Title: WaterPressureSensor - module carrier

Size: A4 | Rev: A3 REVIEW
KiCad E.D.A. 10.0.6 | Id: 1/1
