dnekoz/WaterPressureSensor/hardware/review/user-layout-before.pdf

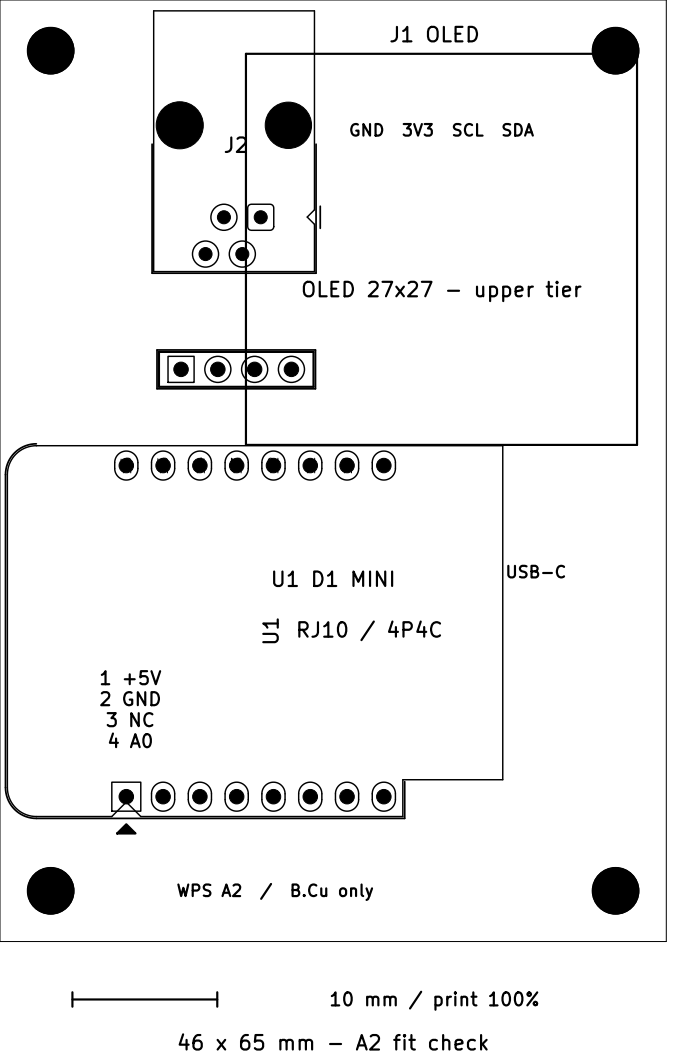
[picture p18: page 1]

J1 OLED

WPS A2 / B.Cu only GND 3V3 SCL SDA USB-C 1 +5V 2 GND
46 x 65 mm - A2 fit check OLED 27x27 - upper tier
