dnekoz/WaterPressureSensor/hardware/cnc/phototools/negative_BOTTOM_VIEW_CONTROL.pdf

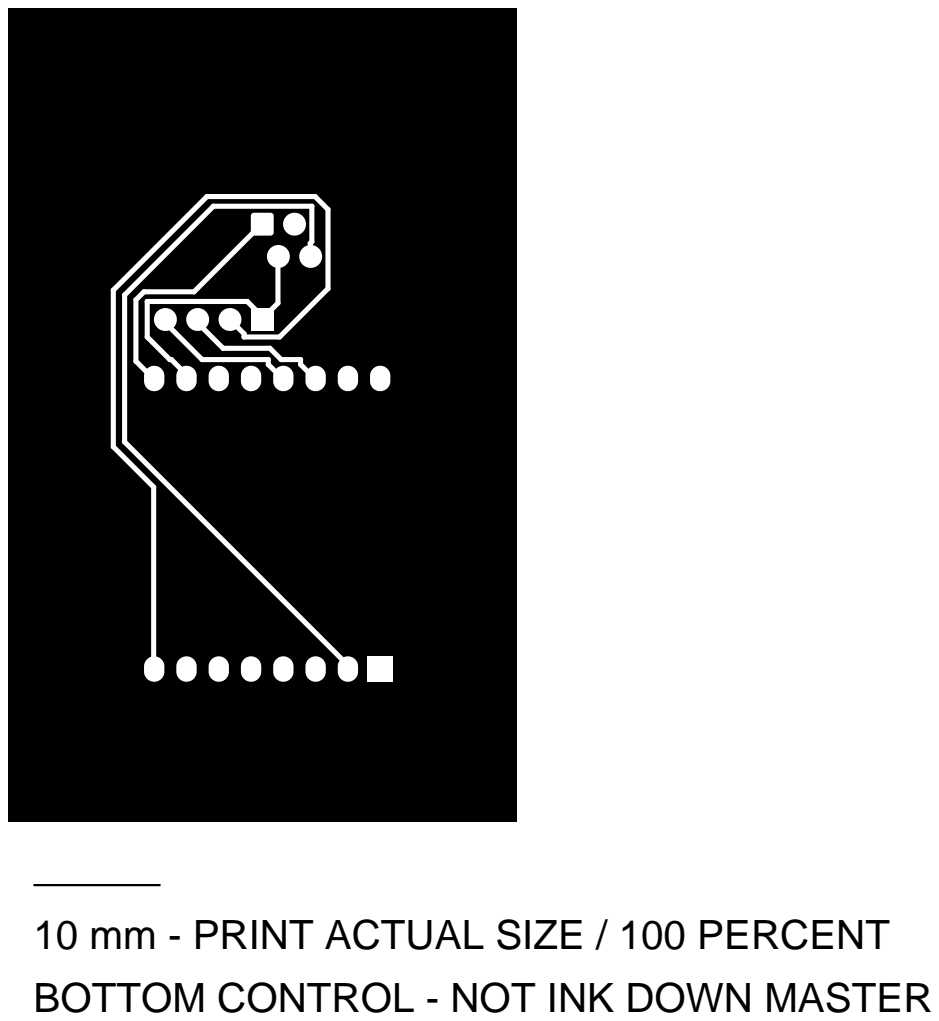
[picture p19: page 1]

10 mm - PRINT ACTUAL SIZE / 100 PERCENT
BOTTOM CONTROL - NOT INK DOWN MASTER
