dnekoz/WaterPressureSensor/hardware/cnc/phototools/negative_PRINT_INK_DOWN.pdf

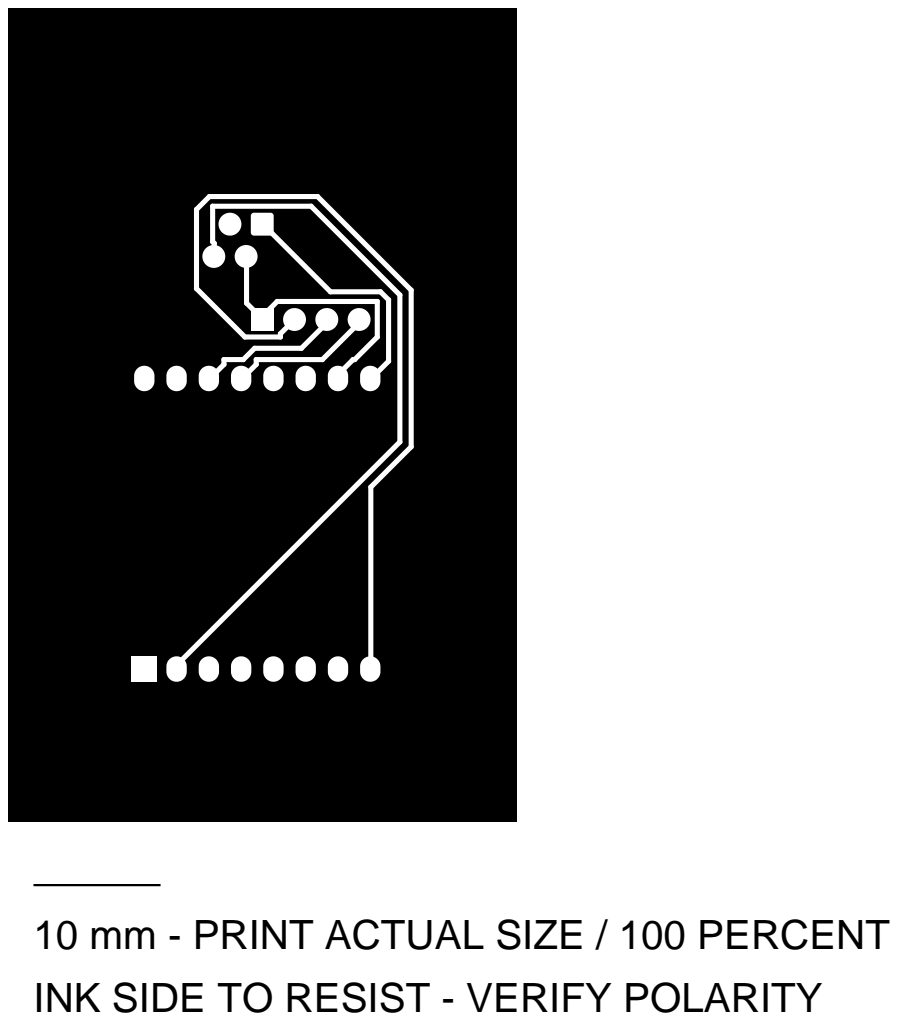
[picture p20: page 1]

10 mm - PRINT ACTUAL SIZE / 100 PERCENT
INK SIDE TO RESIST - VERIFY POLARITY
