dnekoz/WaterPressureSensor/hardware/cnc/phototools/positive_PRINT_INK_DOWN.pdf

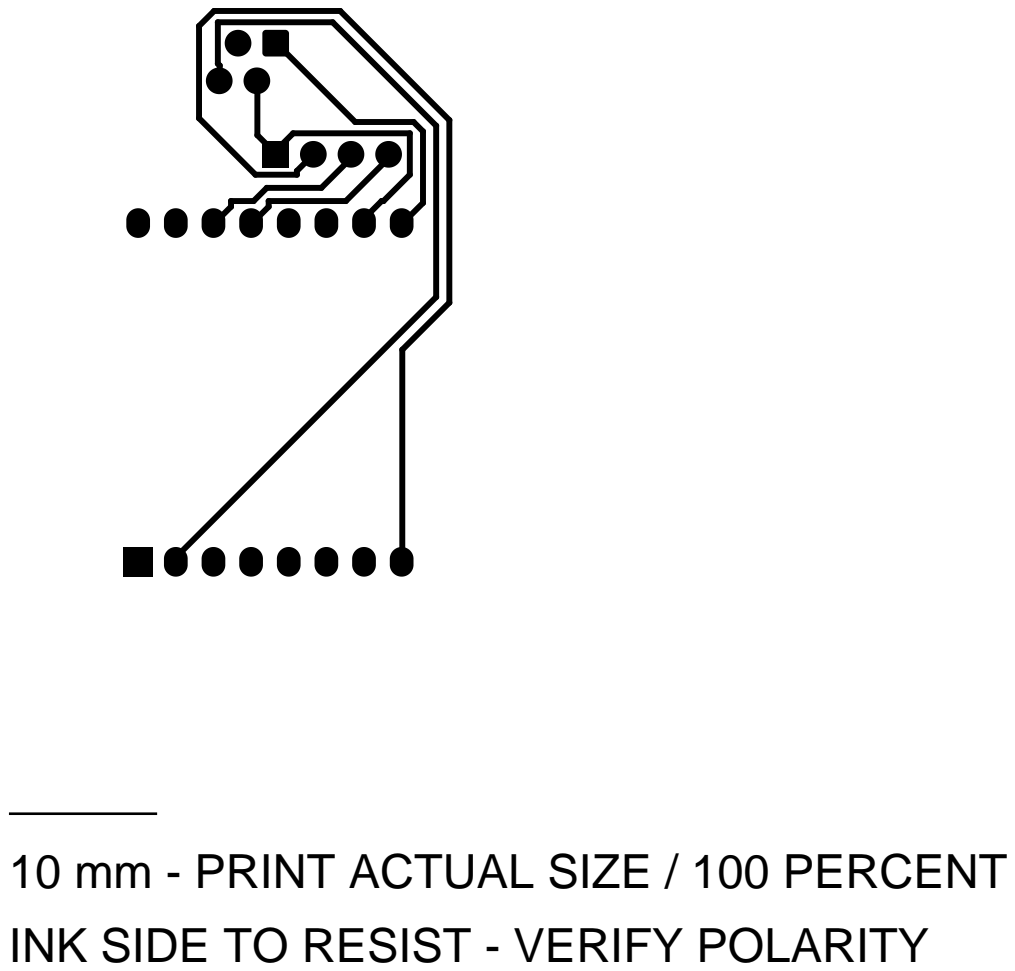
[picture p21: page 1]

10 mm - PRINT ACTUAL SIZE / 100 PERCENT
INK SIDE TO RESIST - VERIFY POLARITY
