dnekoz/WaterPressureSensor/hardware/exports/A2-review/fit-check-1to1.pdf

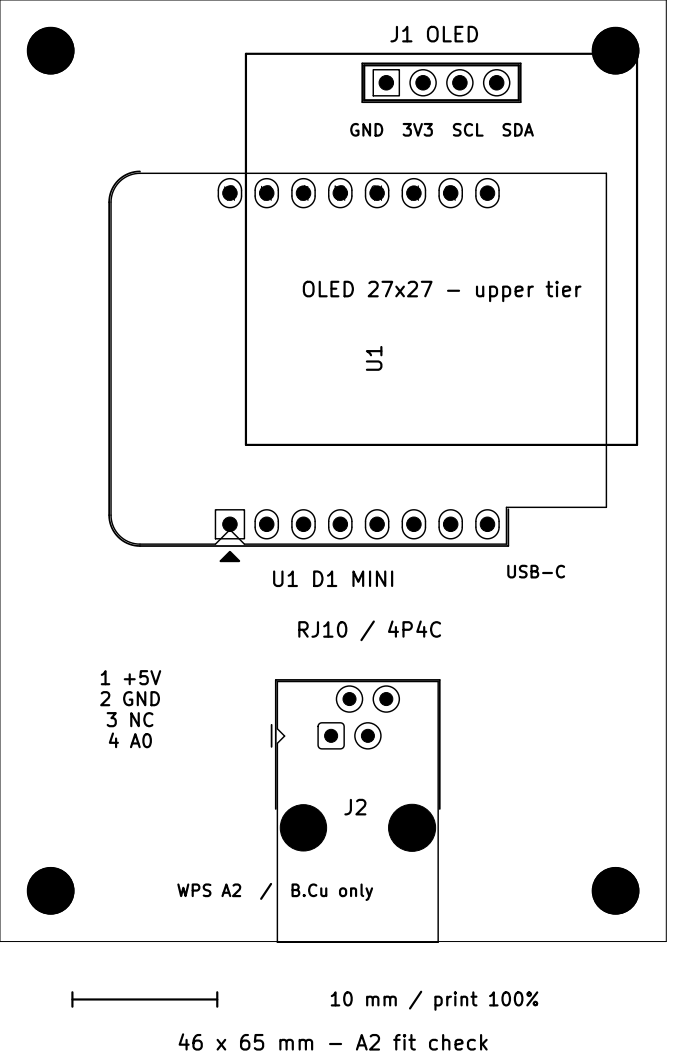
[picture p22: page 1]

46 x 65 mm - A2 fit check OLED 27x27 - upper tier
