dnekoz/WaterPressureSensor/hardware/review/copper-bottom-view.pdf

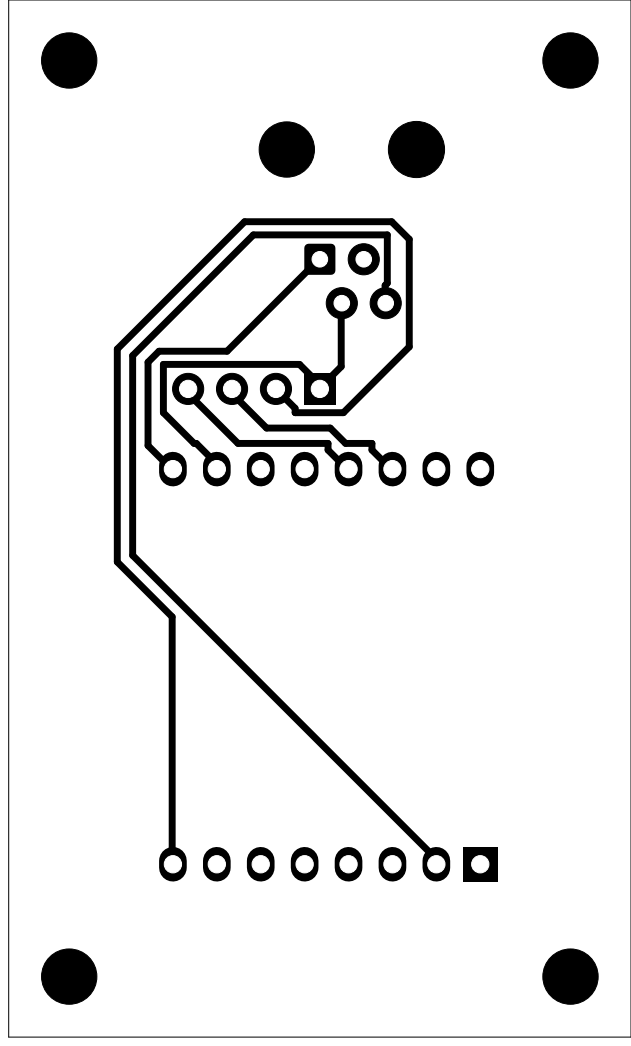
[picture p23: page 1]
