dnekoz/WaterPressureSensor/hardware/exports/A2-review/KiCad/WaterPressureSensor.kicad_pcb

## KiCad design hardware/exports/A2-review/KiCad/WaterPressureSensor.kicad_pcb (2026-10-24)

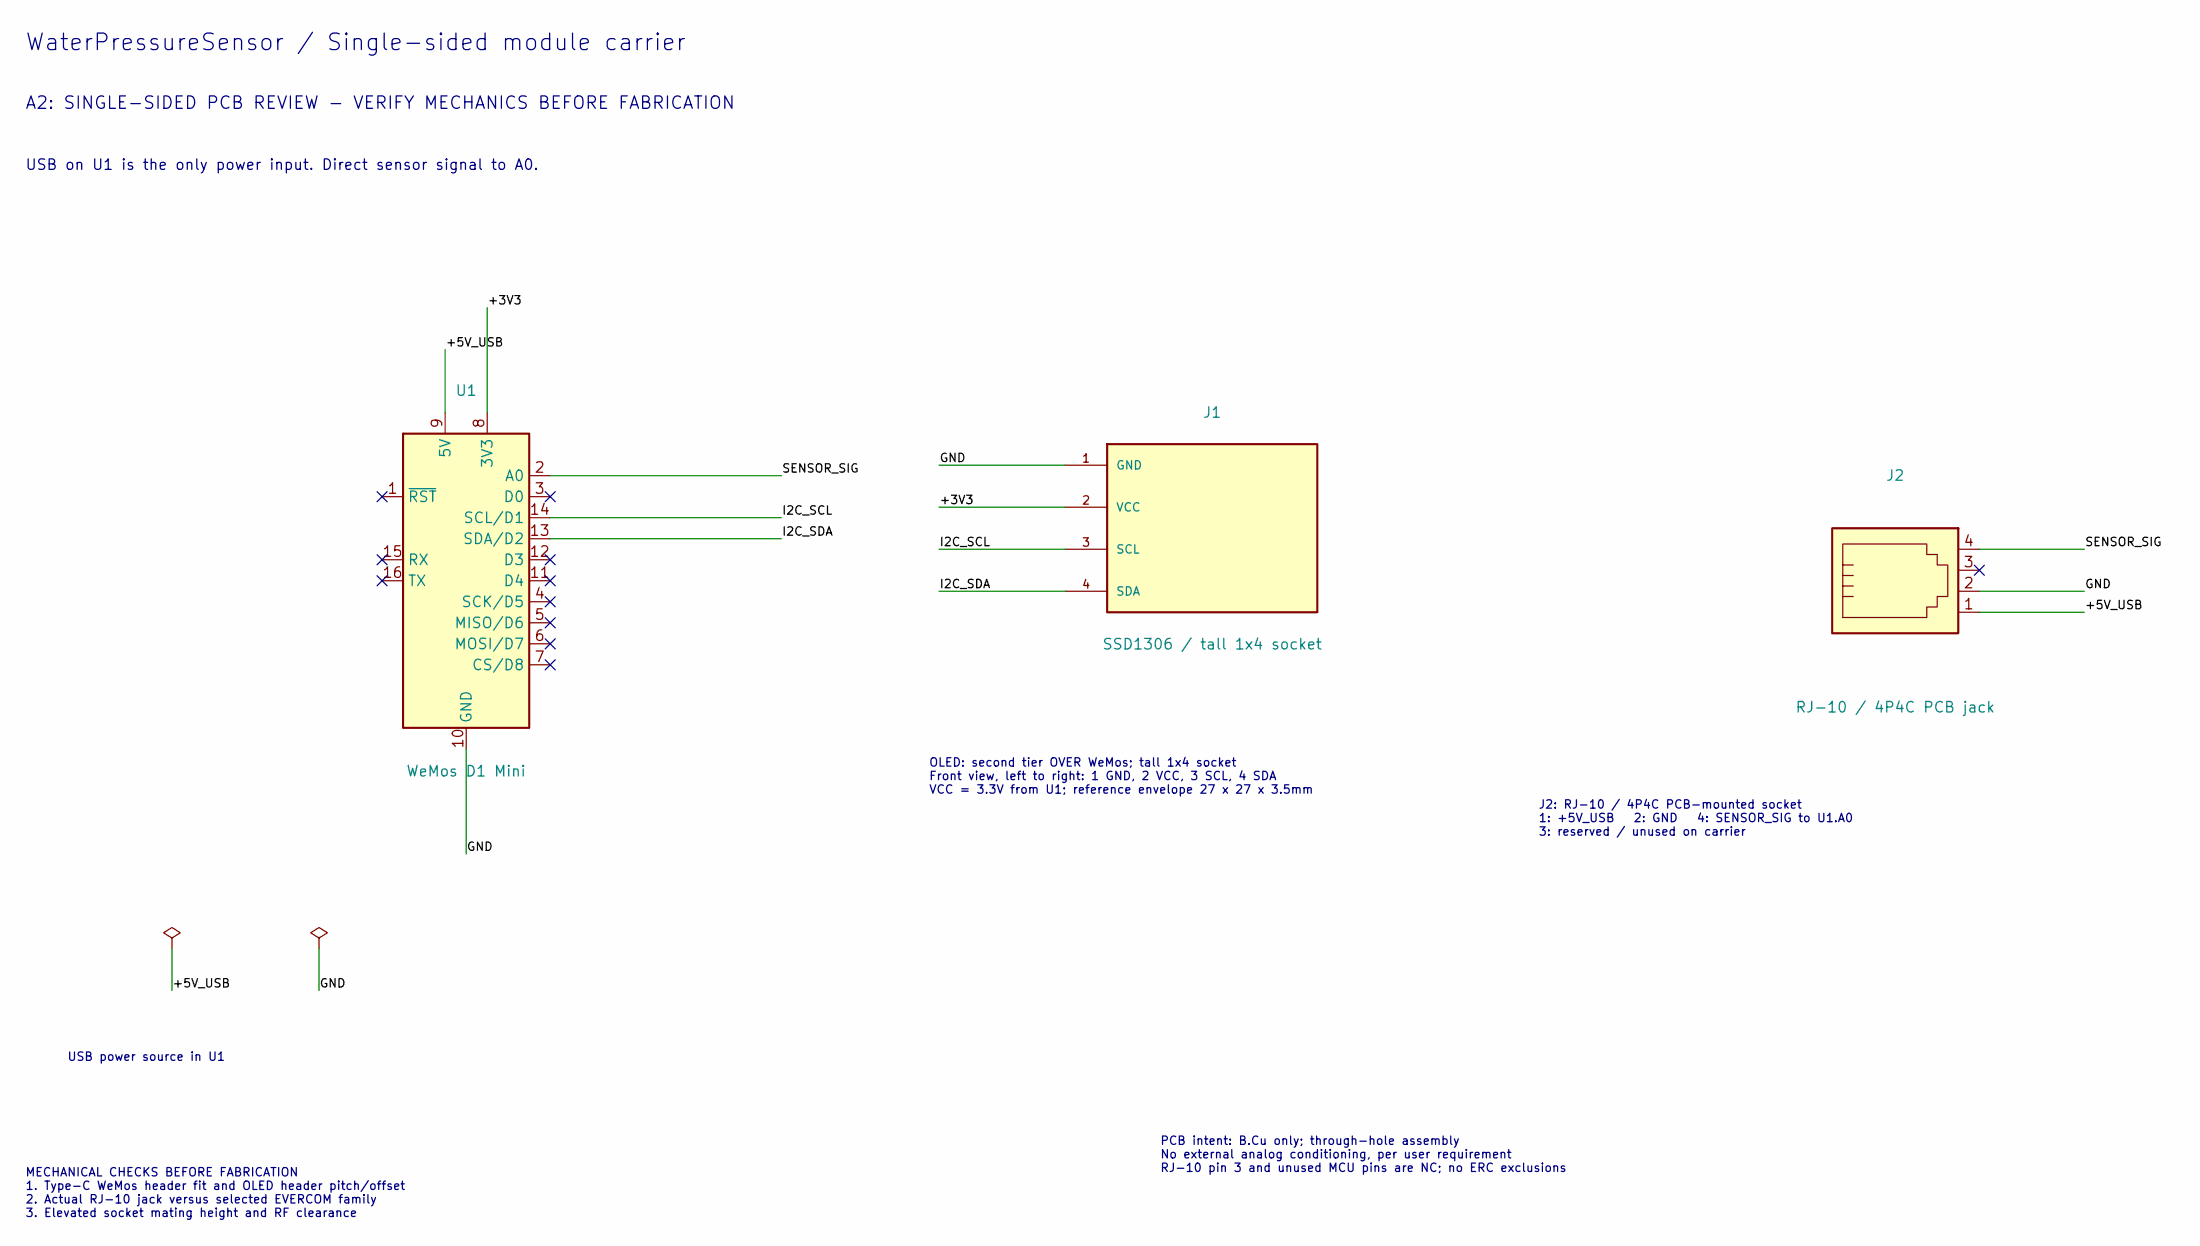
[picture p24: schematic WaterPressureSensor.kicad_sch, WaterPressureSensor - module carrier]

Parts:
J1: SSD1306 / tall 1x4 socket; OLED_ESW_1x04_P2.54_H18.67
J2: RJ-10 / 4P4C PCB jack; RJ10_Evercom_5301_4P4C
U1: WeMos D1 Mini; WEMOS_D1_mini_TypeC_headers

Connections:
/+3V3: J1.2 (VCC), U1.8 (3V3)
/+5V_USB: J2.1, U1.9 (5V)
/GND: J1.1 (GND), J2.2, U1.10 (GND)
/I2C_SCL: J1.3 (SCL), U1.14 (SCL/D1)
/I2C_SDA: J1.4 (SDA), U1.13 (SDA/D2)
/SENSOR_SIG: J2.4, U1.2 (A0)

Notes on the sheet:
WaterPressureSensor / Single-sided module carrier
A2: SINGLE-SIDED PCB REVIEW - VERIFY MECHANICS BEFORE FABRICATION
USB on U1 is the only power input. Direct sensor signal to A0.
USB power source in U1
OLED: second tier OVER WeMos; tall 1x4 socket Front view, left to right: 1 GND, 2 VCC, 3 SCL, 4 SDA VCC = 3.3V from U1; reference envelope 27 x 27 x 3.5mm
J2: RJ-10 / 4P4C PCB-mounted socket 1: +5V_USB 2: GND 4: SENSOR_SIG to U1.A0 3: reserved / unused on carrier
MECHANICAL CHECKS BEFORE FABRICATION 1. Type-C WeMos header fit and OLED header pitch/offset 2. Actual RJ-10 jack versus selected EVERCOM family 3. Elevated socket mating height and RF clearance
PCB intent: B.Cu only; through-hole assembly No external analog conditioning, per user requirement RJ-10 pin 3 and unused MCU pins are NC; no ERC exclusions

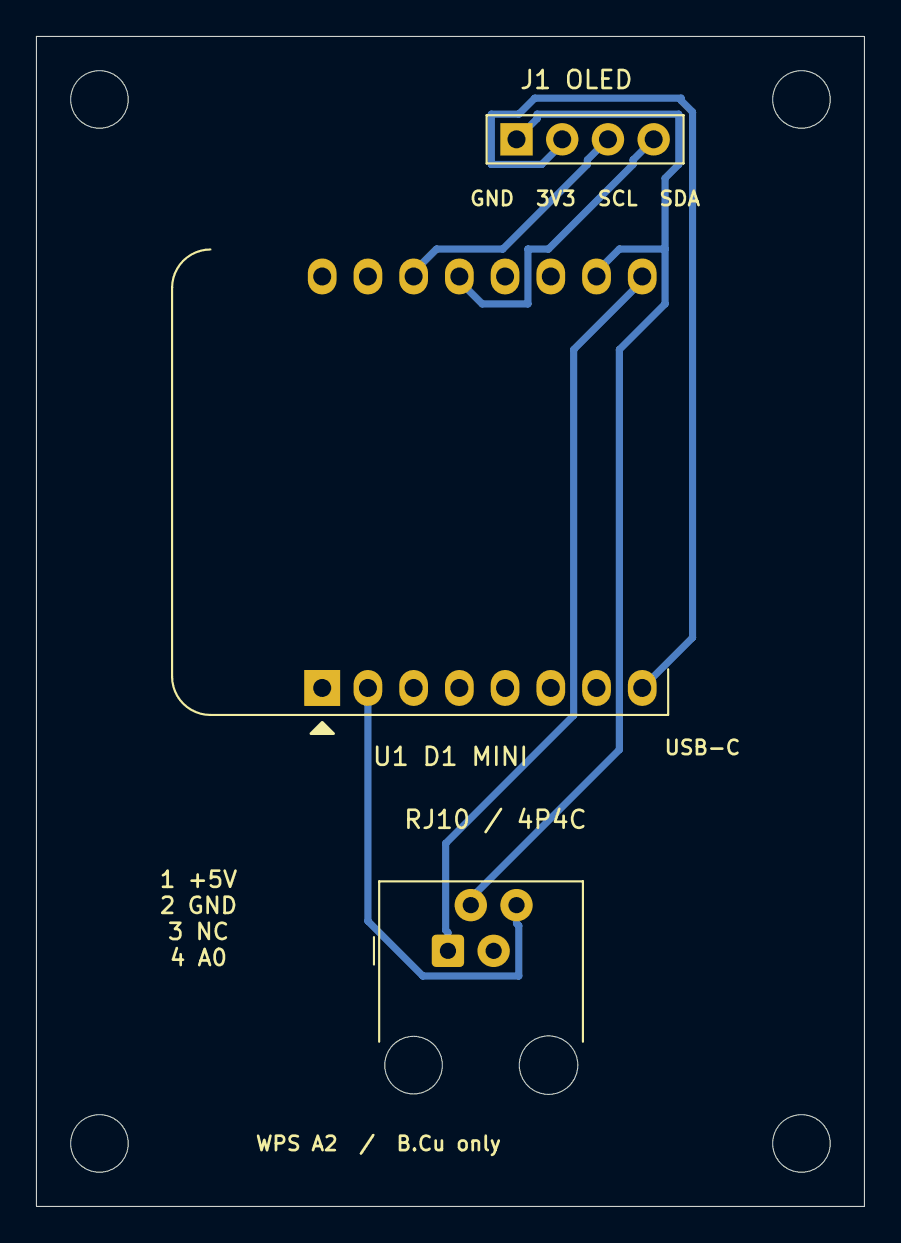
[picture p25: board WaterPressureSensor.kicad_pcb from above]

Board: 2 copper layers, 46.0 x 65.0 mm, 7 parts (0 on the bottom side), 6 nets.

Other parts of the board:
H1, H2, H3, H4: MountingHole_3.2mm_M3
