dnekoz/WaterPressureSensor/(commit log)

2026-10-14 Реализовано в веб интерфейсе при нажатии кнопки "Войти" (Вход в настройки) на OLED экране появляется пароль. Пароль на OLED дисплее должен пропадать, если окне ввода пароля введен пароль и доступ к н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
2026-10-19 Add PCB KiCad version
    [BOM.csv, WaterPressureSensor-CAM.kicad_pcb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]
2026-10-24 fix: обновить SDK и исправить закрытие резервной AP в 3.0.3
    - Перейти на штатный NON-OS SDK 3.0.5(b29dcd3).
    - Исправить переполнение при расчёте возраста AP, вызывавшее её немедленное закрытие.
    - Добавить вывод версии SDK в Serial и API статуса.
    - Добавить отдельную диагностическую сборку и сбор журналов Wi-Fi.
    - Добавить проверку SDK в ELF/BIN и карте линковки в CI.
    - Обновить README и документацию диагностики.
    [Portal.cpp, WifiDiagnostics.cpp, WifiDiagnostics.h, main.cpp]
2026-10-24 fix: обновить SDK и исправить закрытие резервной AP в 3.0.3
